PionixPublic/reference-hardware/(threads)

Thread 5 (2023-12-28):

DNF in schematics - what to do with these components

msozen, 2023-12-28:
Hi,

Maybe a stupid question, but what do we need to do with the components marked as DNF in the schematics?
There are quite a lot, and i expect that we might not be able to get the boards working without these components

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

Here is an example of one of the DNF marked components
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

Br,

corneliusclaussen, 2024-12-04:
DNF means do not fit, so they are not populated on the boards

Thread 9 (2024-12-03):

Control Pilot Signal to PLC jumpers

brandonprry, 2024-12-03:
If powering the Yak board via the 12v power supply separate from the Yeti, how should I connect a control pilot signal to the PLC jumpers on the board for ISO15118 communication?

Please let me know if this question doesn't make sense.

corneliusclaussen, 2024-12-04:
Not sure how your setup looks like. Are you using a yeti or not? In case you only use the yak you will need to have a CP generator externally that creates the pwm (and implements the evse_board_support in Everest), that yak only has the PLC modem and it is connected to the CP signal on the 10 pin connector.

brandonprry, 2024-12-04:
Thanks for the response.

I'm currently experimenting with an ISO15118-20-enabled EVSE and simulating an electric vehicle with the Fluke FEV100. The FEV100 exposes the Control Pilot and I'm attempting to use the Yak separate from the Yeti to perform the EV-side of the V2G communication.

I'm not 100% sure this will work, but I don't see a reason it shouldn't work. I'll test with the J10 pin as soon as possible.

brandonprry, 2024-12-04:
Or should I power the Yak via the 12v port then jumper the pin for the Control Pilot in the 10-pin connector?

brandonprry, 2024-12-04:
Perfect, thanks so much.

corneliusclaussen, 2024-12-04:
The CP is connected from Fluke to CP on the 10pin connector on yak. There is only one 10pin connector that normally connects to yeti. Yak will add the PLC signal to the CP wire.
