PionixPublic/reference-hardware/Yak/CM4_GPIO.kicad_sch

## KiCad design Yak/CM4_GPIO.kicad_sch (2022-12-22)

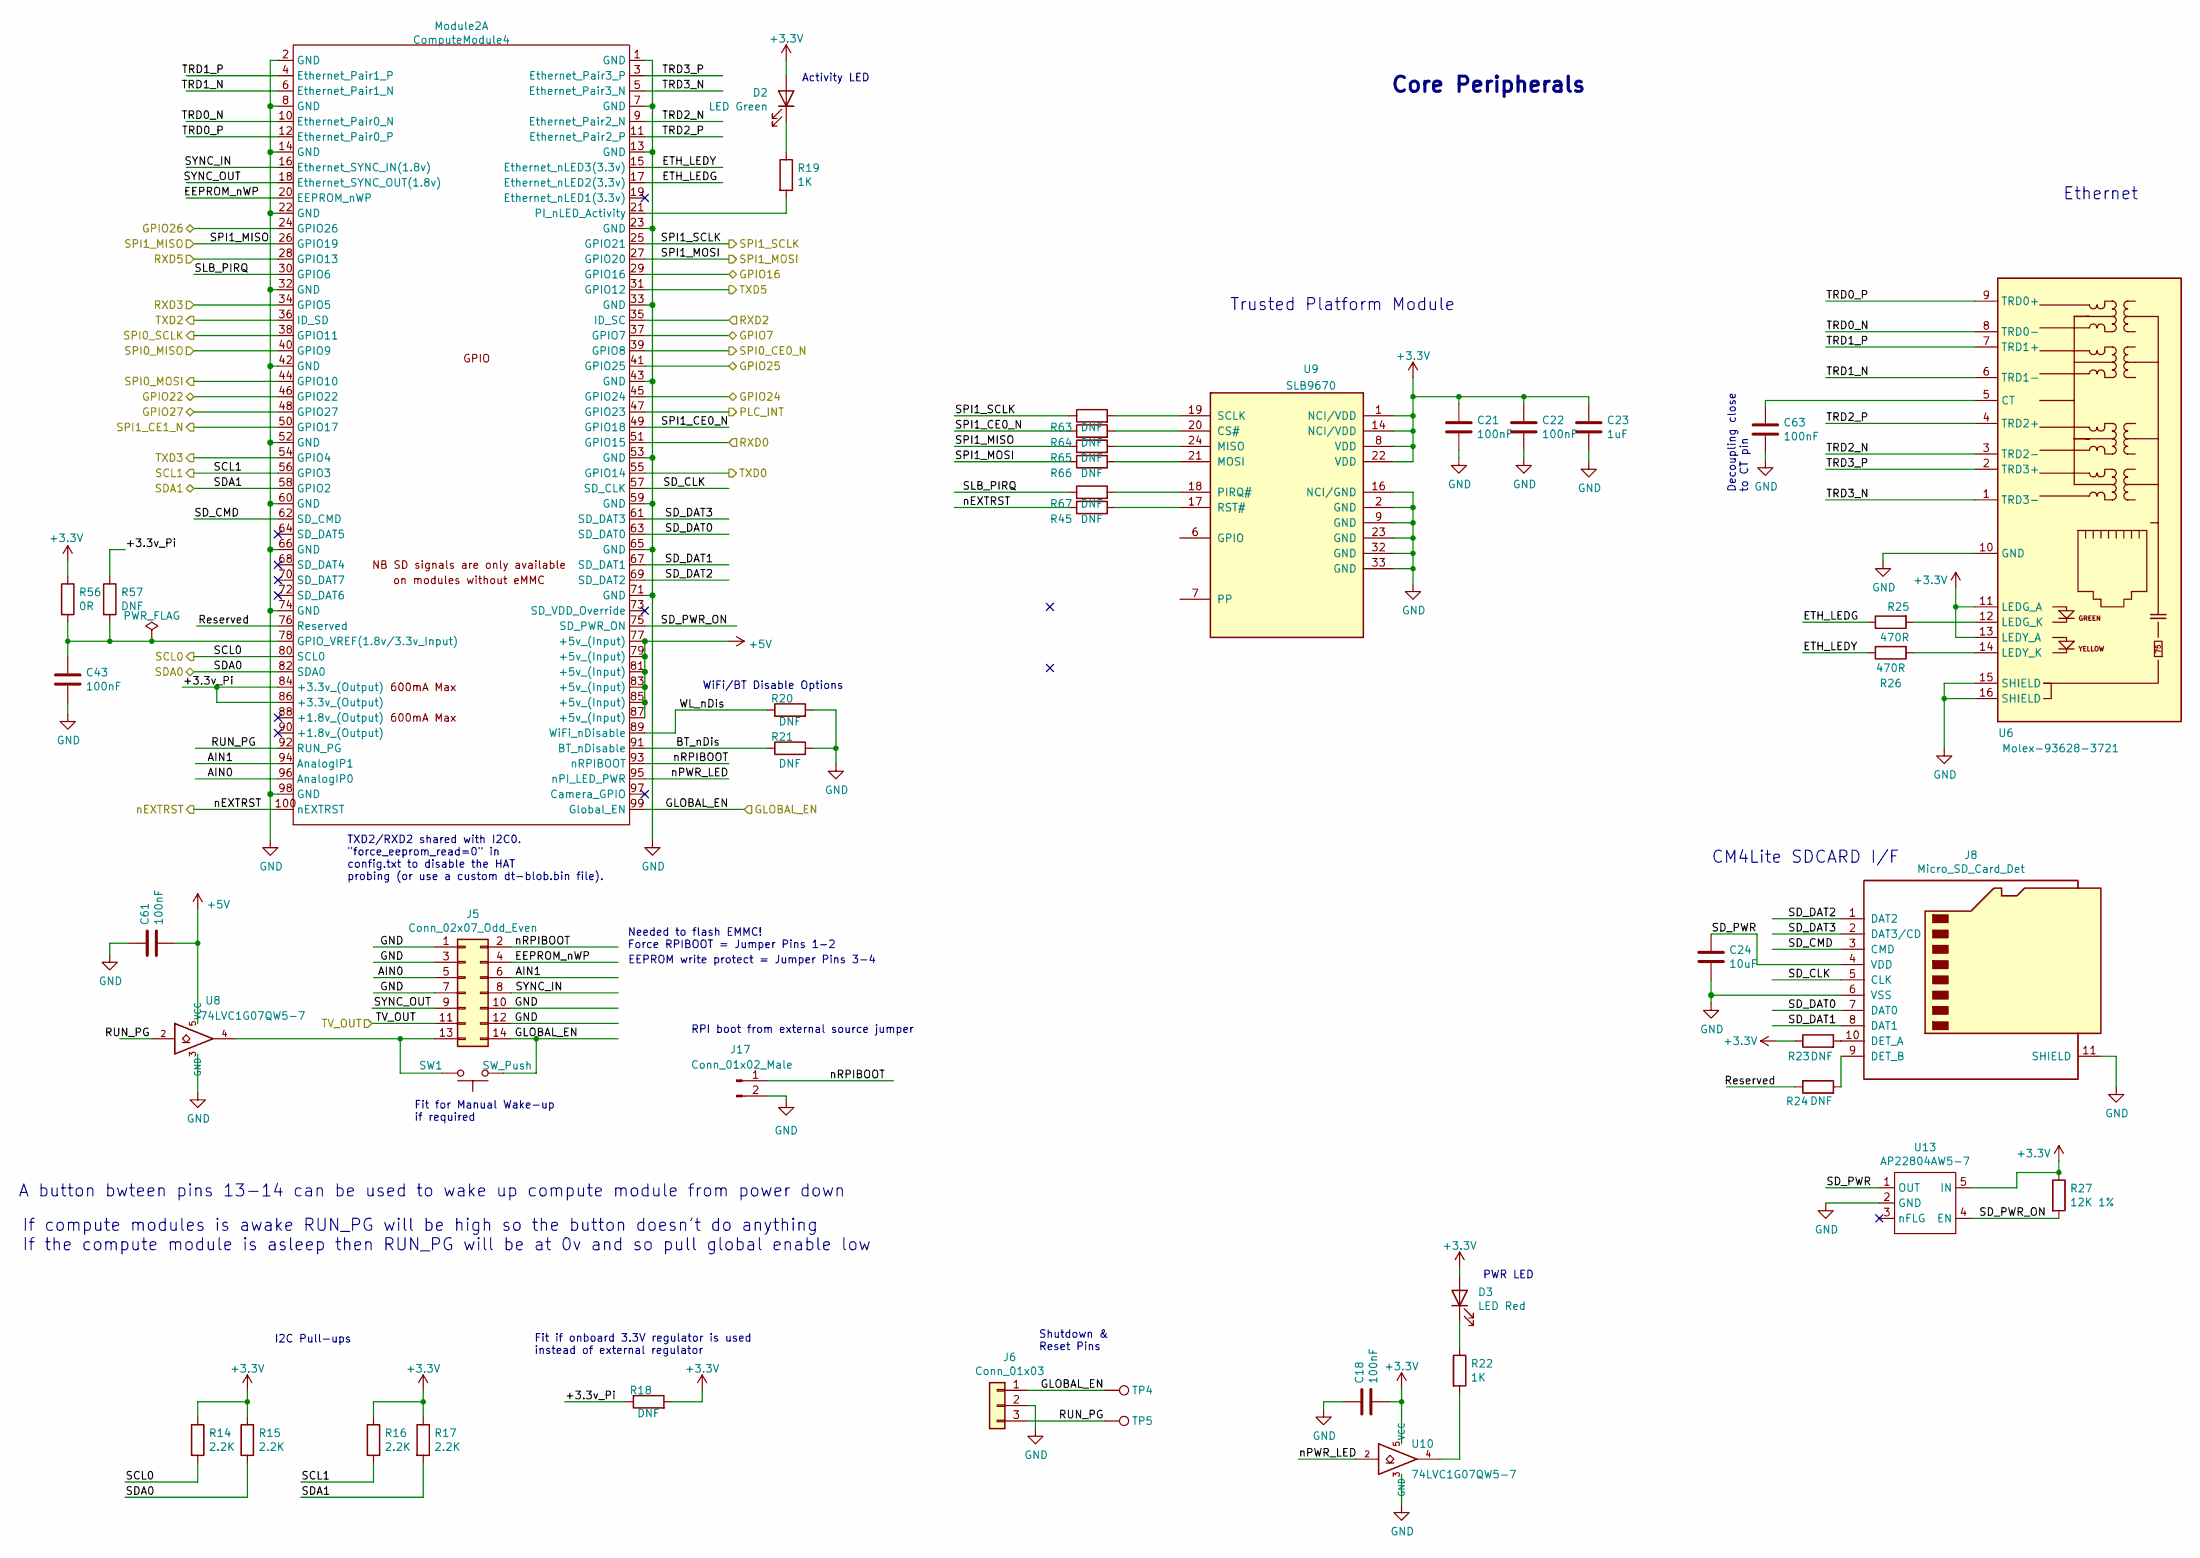
[picture p5: schematic CM4_GPIO.kicad_sch]

Parts:
C18, C21, C22, C43, C61, C63: 100nF; C_0603_1608Metric
C23: 1uF; C_0603_1608Metric
C24: 10uF; C_0805_2012Metric
D2: LED Green; LED_0603_1608Metric; Part Description Green 572nm LED Indication - Discrete 2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
D3: LED Red; LED_0603_1608Metric; Part Description Red 620nm LED Indication - Discrete 2.2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
J5: Conn_02x07_Odd_Even; PinHeader_2x07_P1.27mm_Vertical; Part Description Pin Header, Vertical, Board-to-Board, 1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
J6: Conn_01x03; PinHeader_1x03_P1.27mm_Vertical; Part Description Pin Header, Board-to-Board, 1.27 mm, 1 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
J8: Micro_SD_Card_Det; SDCARD_MOLEX_503398-1892; Part Description 9 (8 + 1) Position Card Connector micro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
J17: Conn_01x02_Male; PinHeader_1x02_P2.54mm_Vertical
Module2: ComputeModule4; Raspberry-Pi-4-Compute-Module; Part Description 100 Position Connector Receptacle, Cent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
R14, R15, R16, R17: 2.2K; R_0603_1608Metric
R18, R20, R21, R23, R24, R45, R57, R63, R64, R65, R66, R67: DNF; R_0603_1608Metric
R19, R22: 1K; R_0603_1608Metric
R25, R26: 470R; R_0603_1608Metric
R27: 12K 1%; R_0603_1608Metric
R56: 0R; R_0603_1608Metric
SW1: SW_Push; SW_Push_1P1T_NO_CK_KMR2; Part Description Tactile Switch, PTSActuated, Surface Mo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
TP4, TP5: TestPoint; TestPoint_THTPad_D1.0mm_Drill0.5mm
U6: Molex-93628-3721; RJ45_Molex_93628-3721_Horizontal; Part Description Modular Connector, RJ45 Jack, 1 x 1 (Po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
U8, U10: 74LVC1G07QW5-7; SOT-23-5; Part Description Buffer, Non-Inverting 1 Element 1 Bit p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
U9: SLB9670; VQFN-32-1EP_5x5mm_P0.5mm_EP3.5x3.5mm; Part Description Trusted Platform Module (TPM)
U13: AP22804AW5-7; SOT-23-5; Part Description Power Switch/Driver 1:1 N-Channel 2.5A 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

Connections:
+3.3V: C18.2, C21.1, C22.1, C23.1, D2.2 (A), D3.2 (A), R14.1, R15.1, R16.1, R17.1, R18.2, R23.1, R27.1, R56.1, U6.11 (LEDG_A), U6.13 (LEDY_A), U9.1 (NCI/VDD), U9.8 (VDD), U9.14 (NCI/VDD), U9.22 (VDD), U10.5 (VCC), U13.5 (IN)
+3.3v_Pi: Module2.84 (+3.3v_(Output)), Module2.86 (+3.3v_(Output)), R18.1, R57.1
+5V: C61.2, Module2.77 (+5v_(Input)), Module2.79 (+5v_(Input)), Module2.81 (+5v_(Input)), Module2.83 (+5v_(Input)), Module2.85 (+5v_(Input)), Module2.87 (+5v_(Input)), U8.5 (VCC)
AIN0: J5.5, Module2.96 (AnalogIP0)
AIN1: J5.6, Module2.94 (AnalogIP1)
BT_nDis: Module2.91 (BT_nDisable), R21.1
EEPROM_nWP: J5.4, Module2.20 (EEPROM_nWP)
ETH_LEDG: Module2.17 (Ethernet_nLED2(3.3v)), R25.1
ETH_LEDY: Module2.15 (Ethernet_nLED3(3.3v)), R26.1
GLOBAL_EN: J5.14, J6.1, Module2.99 (Global_EN), SW1.1, TP4.1
GND: C18.1, C21.2, C22.2, C23.2, C24.2, C43.2, C61.1, C63.2, J5.1, J5.3, J5.7, J5.10, J5.12, J6.2, J8.6 (VSS), J8.11 (SHIELD), J17.2, Module2.1 (GND), Module2.2 (GND), Module2.7 (GND), Module2.8 (GND), Module2.13 (GND), Module2.14 (GND), Module2.22 (GND), Module2.23 (GND), Module2.32 (GND), Module2.33 (GND), Module2.42 (GND), Module2.43 (GND), Module2.52 (GND), Module2.53 (GND), Module2.59 (GND), Module2.60 (GND), Module2.65 (GND), Module2.66 (GND), Module2.71 (GND), Module2.74 (GND), Module2.98 (GND), R20.2, R21.2, U6.10 (GND), U6.15 (SHIELD), U6.16 (SHIELD), U8.3 (GND), U9.2 (GND), U9.9 (GND), U9.16 (NCI/GND), U9.23 (GND), U9.32 (GND), U9.33 (GND), U10.3 (GND), U13.2 (GND)
GPIO7: Module2.37 (GPIO7)
GPIO16: Module2.29 (GPIO16)
GPIO22: Module2.46 (GPIO22)
GPIO24: Module2.45 (GPIO24)
GPIO25: Module2.41 (GPIO25)
GPIO26: Module2.24 (GPIO26)
GPIO27: Module2.48 (GPIO27)
unnamed: C43.1, Module2.78 (GPIO_VREF(1.8v/3.3v_Input)), R56.2, R57.2
unnamed: C63.1, U6.5 (CT)
unnamed: D2.1 (K), R19.1
unnamed: D3.1 (K), R22.1
unnamed: J5.13, SW1.2, U8.4
unnamed: J8.9 (DET_B), R24.2
unnamed: J8.10 (DET_A), R23.2
unnamed: Module2.21 (PI_nLED_Activity), R19.2
unnamed: R22.2, U10.4
unnamed: R25.2, U6.12 (LEDG_K)
unnamed: R26.2, U6.14 (LEDY_K)
unnamed: R45.2, U9.17 (RST#)
unnamed: R63.2, U9.19 (SCLK)
unnamed: R64.2, U9.20 (CS#)
unnamed: R65.2, U9.24 (MISO)
unnamed: R66.2, U9.21 (MOSI)
unnamed: R67.2, U9.18 (PIRQ#)
PLC_INT: Module2.47 (GPIO23)
RUN_PG: J6.3, Module2.92 (RUN_PG), TP5.1, U8.2
RXD0: Module2.51 (GPIO15)
RXD2: Module2.35 (ID_SC)
RXD3: Module2.34 (GPIO5)
RXD5: Module2.28 (GPIO13)
Reserved: Module2.76 (Reserved), R24.1
SCL0: Module2.80 (SCL0), R14.2
SCL1: Module2.56 (GPIO3), R16.2
SDA0: Module2.82 (SDA0), R15.2
SDA1: Module2.58 (GPIO2), R17.2
SD_CLK: J8.5 (CLK), Module2.57 (SD_CLK)
SD_CMD: J8.3 (CMD), Module2.62 (SD_CMD)
SD_DAT0: J8.7 (DAT0), Module2.63 (SD_DAT0)
SD_DAT1: J8.8 (DAT1), Module2.67 (SD_DAT1)
SD_DAT2: J8.1 (DAT2), Module2.69 (SD_DAT2)
SD_DAT3: J8.2 (DAT3/CD), Module2.61 (SD_DAT3)
SD_PWR: C24.1, J8.4 (VDD), U13.1 (OUT)
SD_PWR_ON: Module2.75 (SD_PWR_ON), R27.2, U13.4 (EN)
SLB_PIRQ: Module2.30 (GPIO6), R67.1
SPI0_CE0_N: Module2.39 (GPIO8)
SPI0_MISO: Module2.40 (GPIO9)
SPI0_MOSI: Module2.44 (GPIO10)
SPI0_SCLK: Module2.38 (GPIO11)
SPI1_CE0_N: Module2.49 (GPIO18), R64.1
SPI1_CE1_N: Module2.50 (GPIO17)
SPI1_MISO: Module2.26 (GPIO19), R65.1
SPI1_MOSI: Module2.27 (GPIO20), R66.1
SPI1_SCLK: Module2.25 (GPIO21), R63.1
SYNC_IN: J5.8, Module2.16 (Ethernet_SYNC_IN(1.8v))
SYNC_OUT: J5.9, Module2.18 (Ethernet_SYNC_OUT(1.8v))
TRD0_N: Module2.10 (Ethernet_Pair0_N), U6.8 (TRD0-)
TRD0_P: Module2.12 (Ethernet_Pair0_P), U6.9 (TRD0+)
TRD1_N: Module2.6 (Ethernet_Pair1_N), U6.6 (TRD1-)
TRD1_P: Module2.4 (Ethernet_Pair1_P), U6.7 (TRD1+)
TRD2_N: Module2.9 (Ethernet_Pair2_N), U6.3 (TRD2-)
TRD2_P: Module2.11 (Ethernet_Pair2_P), U6.4 (TRD2+)
TRD3_N: Module2.5 (Ethernet_Pair3_N), U6.1 (TRD3-)
TRD3_P: Module2.3 (Ethernet_Pair3_P), U6.2 (TRD3+)
TV_OUT: J5.11
TXD0: Module2.55 (GPIO14)
TXD2: Module2.36 (ID_SD)
TXD3: Module2.54 (GPIO4)
TXD5: Module2.31 (GPIO12)
WL_nDis: Module2.89 (WiFi_nDisable), R20.1
nEXTRST: Module2.100 (nEXTRST), R45.1
nPWR_LED: Module2.95 (nPI_LED_PWR), U10.2
nRPIBOOT: J5.2, J17.1, Module2.93 (nRPIBOOT)

Notes on the sheet:
A button bwteen pins 13-14 can be used to wake up compute module from power down
Activity LED
Ethernet
Fit for Manual Wake-up if required
WiFi/BT Disable Options
I2C Pull-ups
TXD2/RXD2 shared with I2C0. "force_eeprom_read=0" in config.txt to disable the HAT probing (or use a custom dt-blob.bin file).
EEPROM write protect = Jumper Pins 3-4
If compute modules is awake RUN_PG will be high so the button doesn't do anything If the compute module is asleep then RUN_PG will be at 0v and so pull global enable low
Fit if onboard 3.3V regulator is used instead of external regulator
Decoupling close to CT pin
RPI boot from external source jumper
CM4Lite SDCARD I/F
Needed to flash EMMC! Force RPIBOOT = Jumper Pins 1-2
Core Peripherals
Shutdown & Reset Pins
Trusted Platform Module
PWR LED
