PionixPublic/reference-hardware/Yak/CM4_HighSpeed.kicad_sch

## KiCad design Yak/CM4_HighSpeed.kicad_sch (2022-12-22)

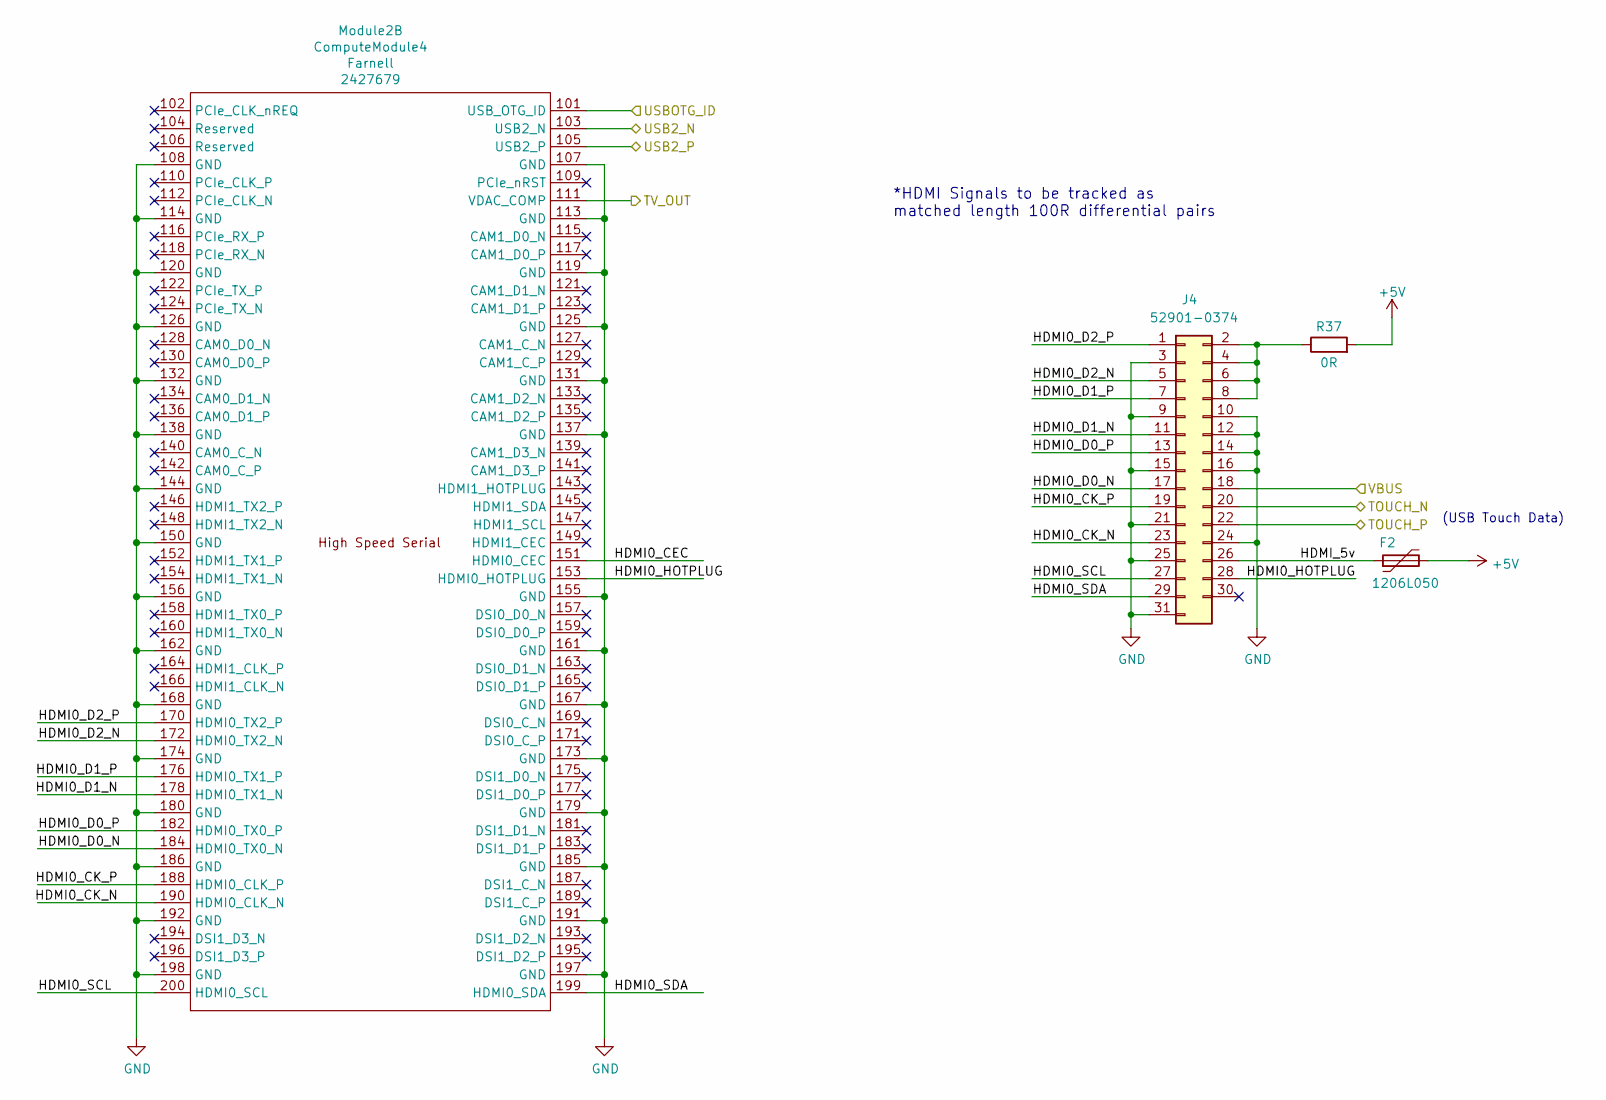
[picture p6: schematic CM4_HighSpeed.kicad_sch]

Parts:
F2: 1206L050; Fuse_1206_3216Metric; Part Description Polymeric PTC ReseFuse 6V 500 mA Ih Sur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
J4: 52901-0374; Molex_SlimStack_52901-0374_2x15_P0.635mm_Vertical; Part Description 30 Position Connector Receptacle, Cente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
Module2: ComputeModule4; Raspberry-Pi-4-Compute-Module; Part Description 100 Position Connector Receptacle, Cent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
R37: 0R; R_0603_1608Metric

Connections:
+5V: F2.2, R37.2
GND: J4.3, J4.9, J4.10, J4.12, J4.14, J4.15, J4.16, J4.21, J4.24, J4.25, J4.31, Module2.107 (GND), Module2.108 (GND), Module2.113 (GND), Module2.114 (GND), Module2.119 (GND), Module2.120 (GND), Module2.125 (GND), Module2.126 (GND), Module2.131 (GND), Module2.132 (GND), Module2.137 (GND), Module2.138 (GND), Module2.144 (GND), Module2.150 (GND), Module2.155 (GND), Module2.156 (GND), Module2.161 (GND), Module2.162 (GND), Module2.167 (GND), Module2.168 (GND), Module2.173 (GND), Module2.174 (GND), Module2.179 (GND), Module2.180 (GND), Module2.185 (GND), Module2.186 (GND), Module2.191 (GND), Module2.192 (GND), Module2.197 (GND), Module2.198 (GND)
HDMI0_CEC: Module2.151 (HDMI0_CEC)
HDMI0_CK_N: J4.23, Module2.190 (HDMI0_CLK_N)
HDMI0_CK_P: J4.19, Module2.188 (HDMI0_CLK_P)
HDMI0_D0_N: J4.17, Module2.184 (HDMI0_TX0_N)
HDMI0_D0_P: J4.13, Module2.182 (HDMI0_TX0_P)
HDMI0_D1_N: J4.11, Module2.178 (HDMI0_TX1_N)
HDMI0_D1_P: J4.7, Module2.176 (HDMI0_TX1_P)
HDMI0_D2_N: J4.5, Module2.172 (HDMI0_TX2_N)
HDMI0_D2_P: J4.1, Module2.170 (HDMI0_TX2_P)
HDMI0_HOTPLUG: J4.28, Module2.153 (HDMI0_HOTPLUG)
HDMI0_SCL: J4.27, Module2.200 (HDMI0_SCL)
HDMI0_SDA: J4.29, Module2.199 (HDMI0_SDA)
HDMI_5v: F2.1, J4.26
unnamed: J4.2, J4.4, J4.6, J4.8, R37.1
TOUCH_N: J4.20
TOUCH_P: J4.22
TV_OUT: Module2.111 (VDAC_COMP)
USB2_N: Module2.103 (USB2_N)
USB2_P: Module2.105 (USB2_P)
USBOTG_ID: Module2.101 (USB_OTG_ID)
VBUS: J4.18

Notes on the sheet:
*HDMI Signals to be tracked as matched length 100R differential pairs
(USB Touch Data)
