PionixPublic/reference-hardware/Yak/RTC.kicad_sch

## KiCad design Yak/RTC.kicad_sch (2022-12-22)

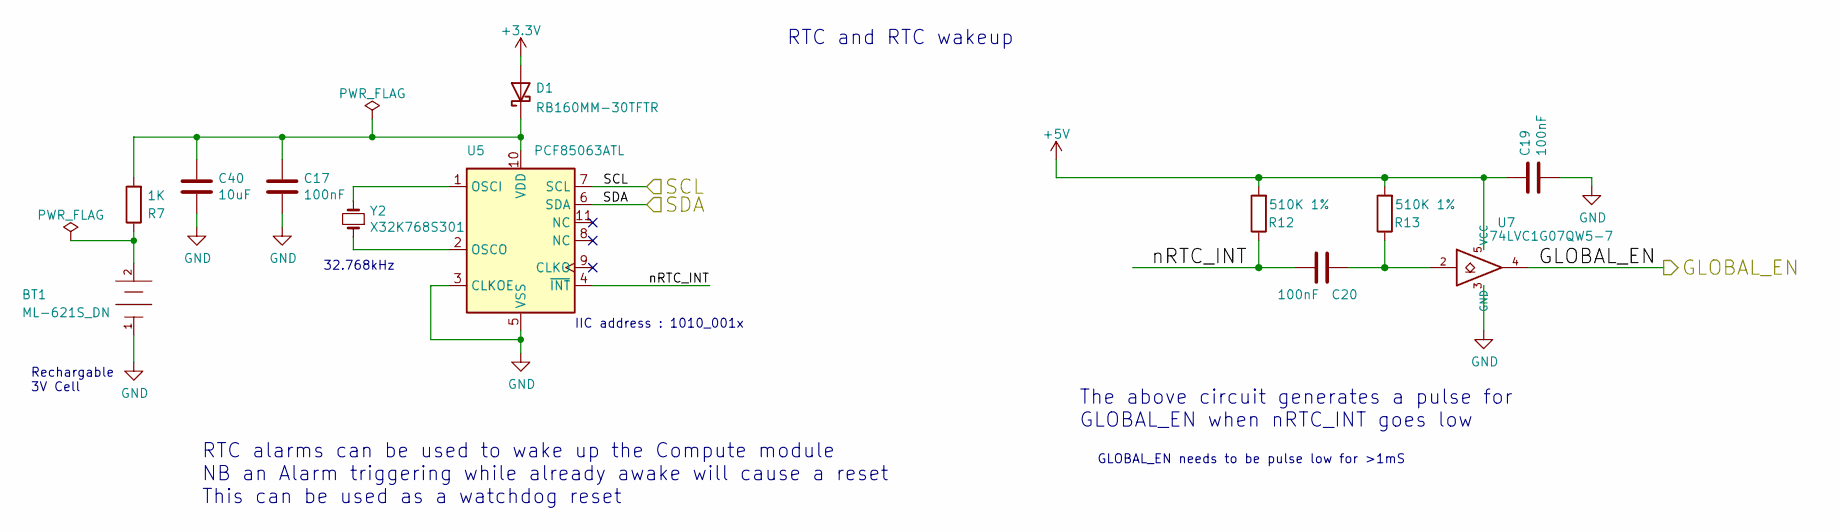
[picture p7: schematic RTC.kicad_sch]

Parts:
BT1: ML-621S_DN; Panasonic-ML-621S_DN-0-0-MFG; mouser part number 658-ML-621S/DN; digikey description BATTERY LITH 3V 5MAH COIN 6.8MM
C17, C19, C20: 100nF; C_0603_1608Metric
C40: 10uF; C_0805_2012Metric
D1: RB160MM-30TFTR; D_SOD-123F; Part Description 30V 1A SOD-123F 480mV Schottky Diode
R7: 1K; R_0603_1608Metric
R12, R13: 510K 1%; R_0603_1608Metric
U5: PCF85063ATL; NXP_Semiconductors-SOT1197-1-02_2016-0-MFG; Part Description Realtime Clock/Calendar I2C Interface
U7: 74LVC1G07QW5-7; SOT-23-5; Part Description Buffer, Non-Inverting 1 Element 1 Bit p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
Y2: X32K768S301; Crystal_SMD_3215-2Pin_3.2x1.5mm; Part Description Crystal 32.768KHz 7pF 20pmm

Connections:
+3.3V: D1.2 (A)
+5V: C19.1, R12.2, R13.2, U7.5 (VCC)
GLOBAL_EN: U7.4
GND: BT1.1 (CATHODE), C17.2, C19.2, C40.2, U5.3 (CLKOE), U5.5 (VSS), U7.3 (GND)
unnamed: BT1.2 (ANODE), R7.1
unnamed: C17.1, C40.1, D1.1 (K), R7.2, U5.10 (VDD)
unnamed: C20.1, R13.1, U7.2
unnamed: U5.1 (OSCI), Y2.2
unnamed: U5.2 (OSCO), Y2.1
SCL: U5.7 (SCL)
SDA: U5.6 (SDA)
nRTC_INT: C20.2, R12.1, U5.4 (~INT)

Notes on the sheet:
RTC and RTC wakeup
The above circuit generates a pulse for GLOBAL_EN when nRTC_INT goes low
Rechargable 3V Cell
32.768kHz
GLOBAL_EN needs to be pulse low for >1mS
RTC alarms can be used to wake up the Compute module NB an Alarm triggering while already awake will cause a reset This can be used as a watchdog reset
IIC address : 1010_001x
