PionixPublic/reference-hardware/Yak/USB2-HUB.kicad_sch

## KiCad design Yak/USB2-HUB.kicad_sch (2022-12-22)

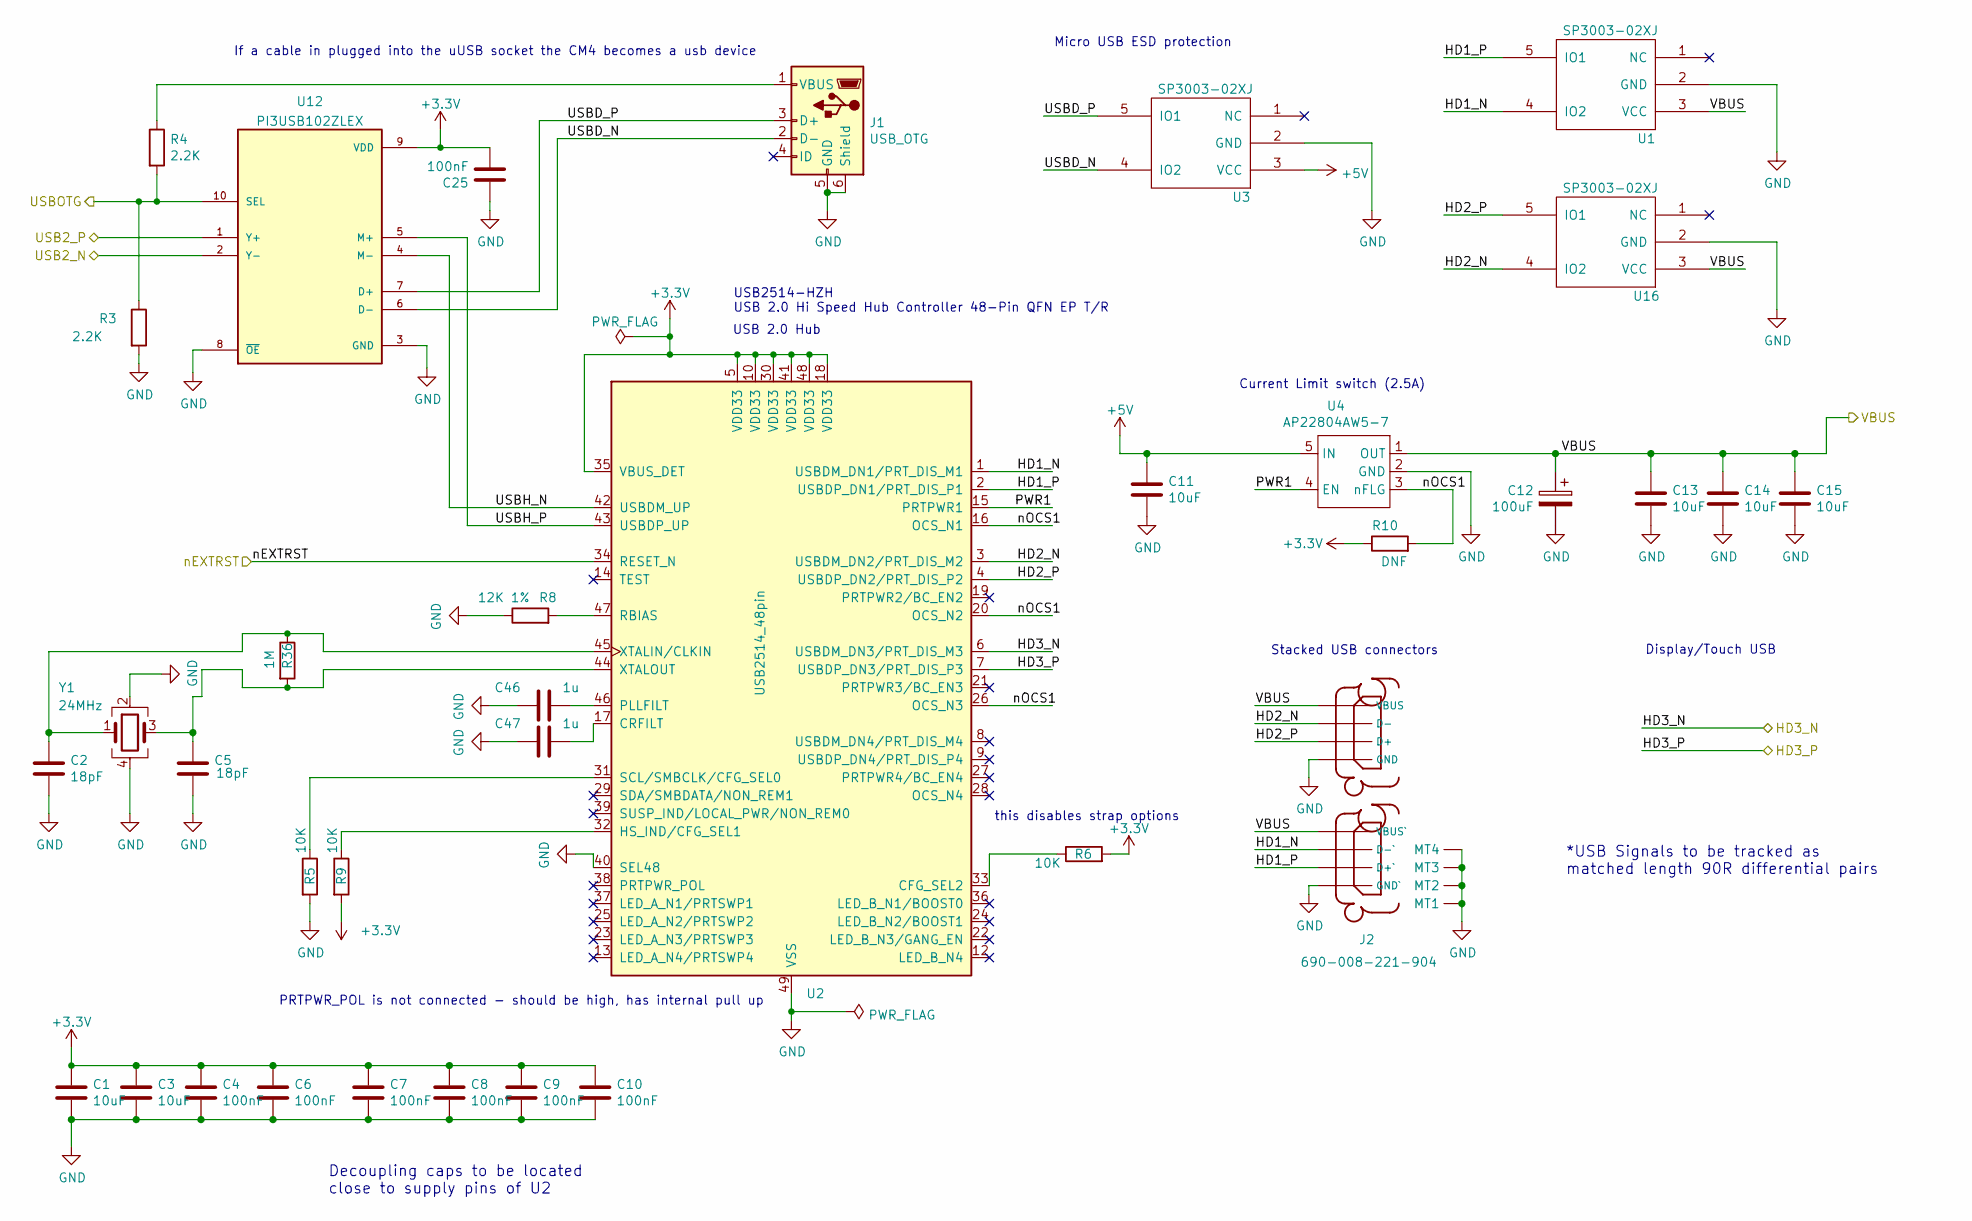
[picture p8: schematic USB2-HUB.kicad_sch]

Parts:
C1, C3, C11, C13, C14, C15: 10uF; C_0805_2012Metric
C2, C5: 18pF; C_0603_1608Metric
C4, C6, C7, C8, C9, C10, C25: 100nF; C_0603_1608Metric
C12: 100uF; CP_Elec_6.3x3; Part Description 100 µF 16 V Aluminum - Polymer Capacito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
C46, C47: 1u; C_0603_1608Metric
J1: USB_OTG; USB_Micro-B_EDAC_UCON00686; Part Description USB - micro B USB 2.0 Receptacle Connec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
J2: 690-008-221-904; MOLEX_USB_67298-4090; Part Description USB-A (USB TYPE-A), Stacked Receptacle 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
R3, R4: 2.2K; R_0603_1608Metric
R5, R6, R9: 10K; R_0603_1608Metric
R8: 12K 1%; R_0603_1608Metric
R10: DNF; R_0603_1608Metric
R36: 1M; R_0603_1608Metric
U1, U3, U16: SP3003-02XJ; SC70-5; Part Description TVS Diode USB
U2: USB2514_48pin; QFN-48-1EP_7x7mm_P0.5mm_EP4.1x4.1mm
U4: AP22804AW5-7; SOT-23-5; Part Description Power Switch/Driver 1:1 N-Channel 2.5A 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
U12: PI3USB102ZLEX; SW_PI3USB102ZLEX; Part Description USB Switch IC 1 Channel 10-TQFN
Y1: 24MHz; Crystal_SMD_Abracon_ABM8G-4Pin_3.2x2.5mm; Part Description Crystal, 24 MHz, SMD, 3.2mm x 2.5mm, 10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

Connections:
+3.3V: C1.1, C3.1, C4.1, C6.1, C7.1, C8.1, C9.1, C10.1, C25.2, R6.2, R9.2, R10.1, U2.5 (VDD33), U2.10 (VDD33), U2.18 (VDD33), U2.30 (VDD33), U2.35 (VBUS_DET), U2.41 (VDD33), U2.48 (VDD33), U12.9 (VDD)
+5V: C11.1, U3.3 (VCC), U4.5 (IN)
GND: C1.2, C2.2, C3.2, C4.2, C5.2, C6.2, C7.2, C8.2, C9.2, C10.2, C11.2, C12.2, C13.2, C14.2, C15.2, C25.1, C46.1, C47.1, J1.5 (GND), J1.6 (Shield), J2.4 (GND`), J2.8 (GND), J2.MT1, J2.MT2, J2.MT3, J2.MT4, R3.2, R5.2, R8.1, U1.2 (GND), U2.40 (SEL48), U2.49 (VSS), U3.2 (GND), U4.2 (GND), U12.3 (GND), U12.8 (~OE), U16.2 (GND), Y1.2, Y1.4
HD1_N: J2.2 (D-`), U1.4 (IO2), U2.1 (USBDM_DN1/PRT_DIS_M1)
HD1_P: J2.3 (D+`), U1.5 (IO1), U2.2 (USBDP_DN1/PRT_DIS_P1)
HD2_N: J2.6 (D-), U2.3 (USBDM_DN2/PRT_DIS_M2), U16.4 (IO2)
HD2_P: J2.7 (D+), U2.4 (USBDP_DN2/PRT_DIS_P2), U16.5 (IO1)
HD3_N: U2.6 (USBDM_DN3/PRT_DIS_M3)
HD3_P: U2.7 (USBDP_DN3/PRT_DIS_P3)
unnamed: C2.1, R36.1, U2.45 (XTALIN/CLKIN), Y1.1
unnamed: C5.1, R36.2, U2.44 (XTALOUT), Y1.3
unnamed: C46.2, U2.46 (PLLFILT)
unnamed: C47.2, U2.17 (CRFILT)
unnamed: J1.1 (VBUS), R4.1
unnamed: R5.1, U2.31 (SCL/SMBCLK/CFG_SEL0)
unnamed: R6.1, U2.33 (CFG_SEL2)
unnamed: R8.2, U2.47 (RBIAS)
unnamed: R9.1, U2.32 (HS_IND/CFG_SEL1)
PWR1: U2.15 (PRTPWR1), U4.4 (EN)
USB2_N: U12.2 (Y-)
USB2_P: U12.1 (Y+)
USBD_N: J1.2 (D-), U3.4 (IO2), U12.6 (D-)
USBD_P: J1.3 (D+), U3.5 (IO1), U12.7 (D+)
USBH_N: U2.42 (USBDM_UP), U12.4 (M-)
USBH_P: U2.43 (USBDP_UP), U12.5 (M+)
USBOTG: R3.1, R4.2, U12.10 (SEL)
VBUS: C12.1, C13.1, C14.1, C15.1, J2.1 (VBUS`), J2.5 (VBUS), U1.3 (VCC), U4.1 (OUT), U16.3 (VCC)
nEXTRST: U2.34 (RESET_N)
nOCS1: R10.2, U2.16 (OCS_N1), U2.20 (OCS_N2), U2.26 (OCS_N3), U4.3 (nFLG)

Notes on the sheet:
USB 2.0 Hub
*USB Signals to be tracked as matched length 90R differential pairs
Display/Touch USB
Current Limit switch (2.5A)
USB2514-HZH USB 2.0 Hi Speed Hub Controller 48-Pin QFN EP T/R
PRTPWR_POL is not connected - should be high, has internal pull up
Stacked USB connectors
If a cable in plugged into the uUSB socket the CM4 becomes a usb device
Decoupling caps to be located close to supply pins of U2
this disables strap options
Micro USB ESD protection
