PionixPublic/reference-hardware/Yak/everestCM4.kicad_sch

## KiCad design Yak/everestCM4.kicad_sch (2022-12-22)

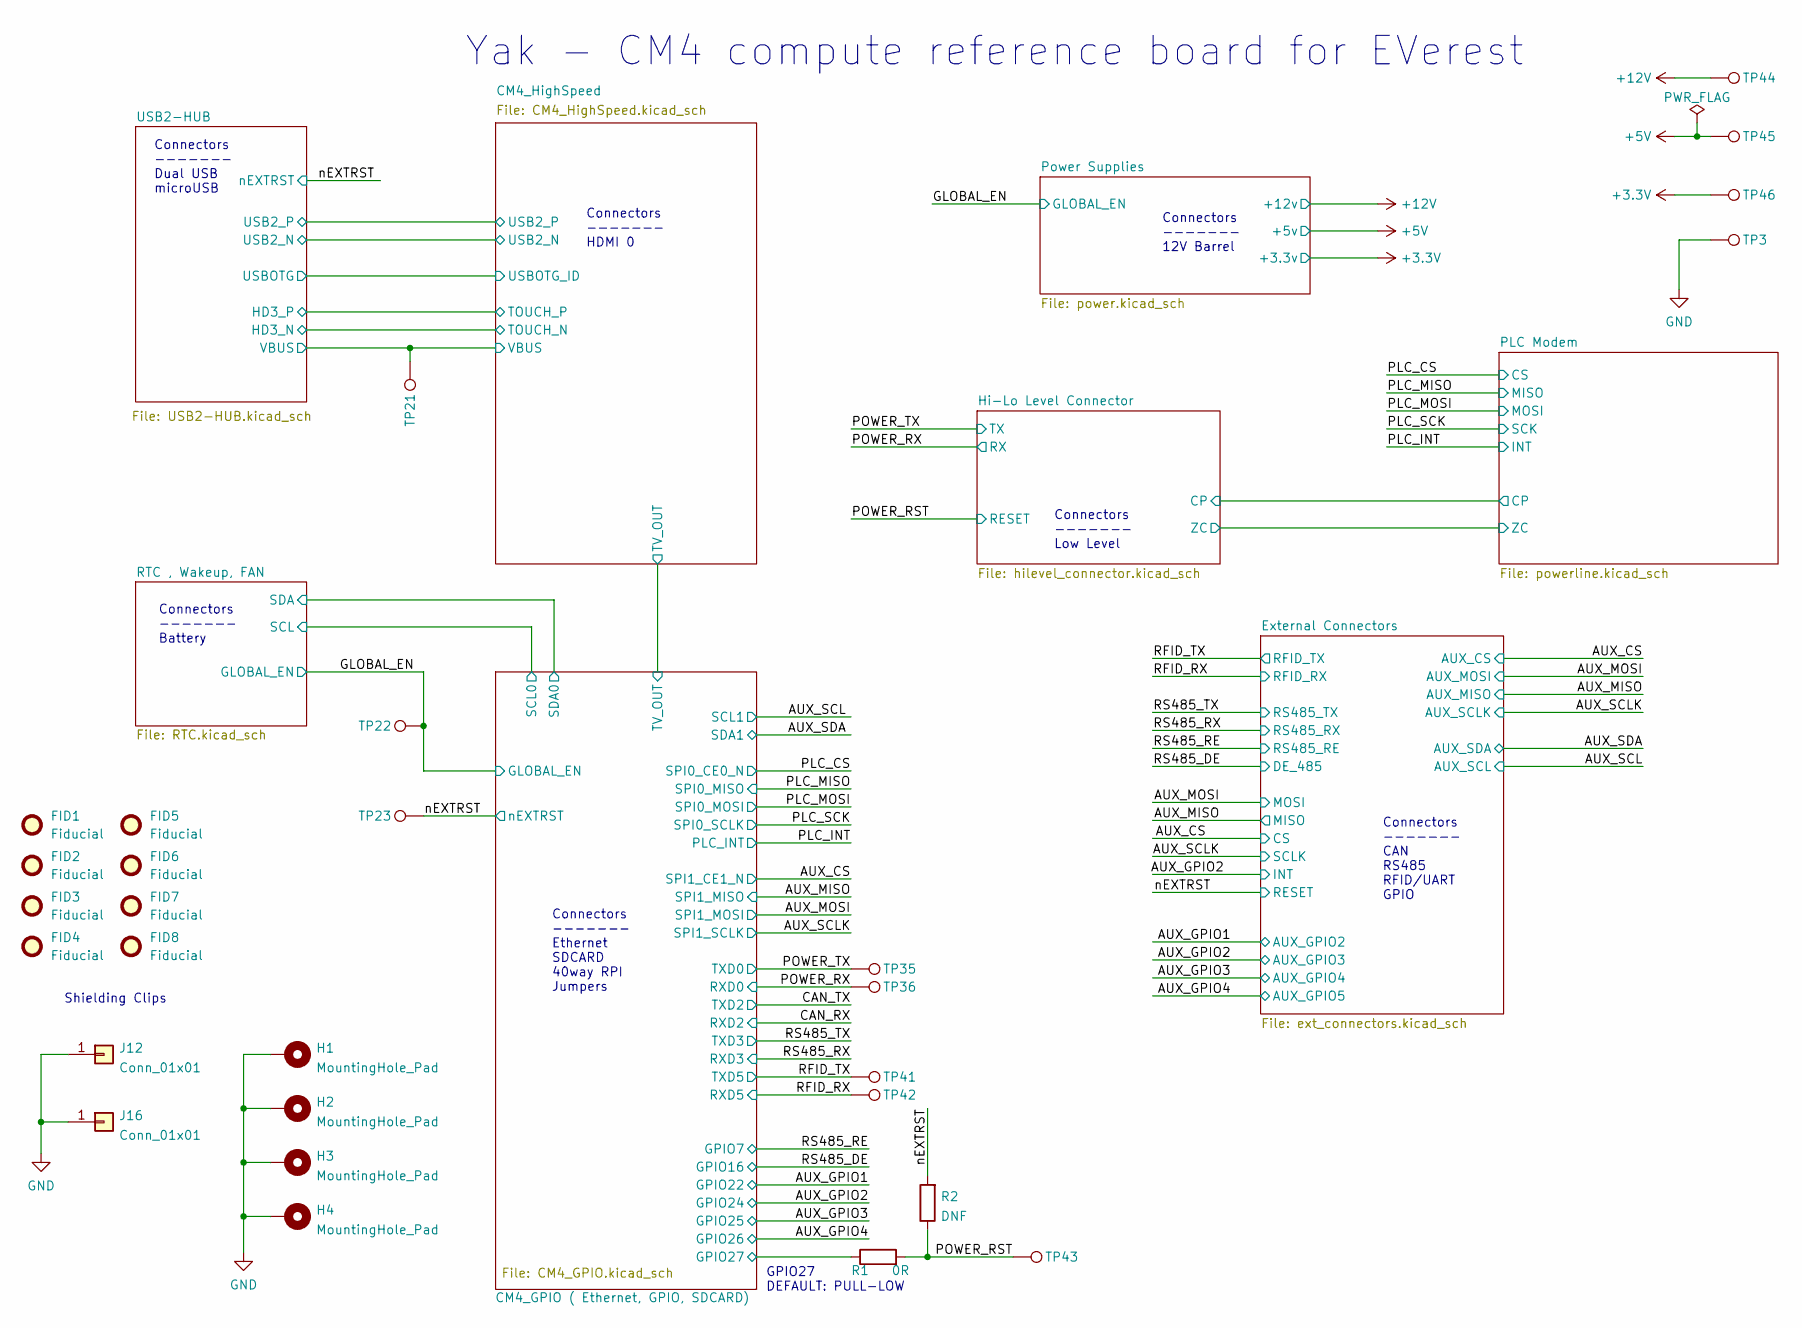
[picture p9: schematic everestCM4.kicad_sch]

Parts:
FID1, FID2, FID3, FID4, FID5, FID6, FID7, FID8: Fiducial; Fiducial_1mm_Mask3mm
H1, H2, H3, H4: MountingHole_Pad; MountingHole_3.2mm_M3_ISO7380_Pad
J12, J16: Conn_01x01; S2711-46R_SheildClip; Part Description Sheilding Clip
R1: 0R; R_0603_1608Metric
R2: DNF; R_0603_1608Metric
TP3, TP21, TP22, TP23, TP35, TP36, TP41, TP42, TP43, TP44, TP45, TP46: TestPoint; TestPoint_THTPad_D1.0mm_Drill0.5mm

Connections:
+3.3V: TP46.1
+5V: TP45.1
+12V: TP44.1
GLOBAL_EN: TP22.1
GND: H1.1, H2.1, H3.1, H4.1, J12.1, J16.1, TP3.1
GPIO27: R1.1
POWER_RST: R1.2, R2.1, TP43.1
POWER_RX: TP36.1
POWER_TX: TP35.1
RFID_RX: TP42.1
RFID_TX: TP41.1
VBUS: TP21.1
nEXTRST: R2.2, TP23.1

Notes on the sheet:
Connectors ------- Ethernet SDCARD 40way RPI Jumpers
Connectors ------- HDMI 0
GPIO27 DEFAULT: PULL-LOW
Connectors ------- Dual USB microUSB
Connectors ------- CAN RS485 RFID/UART GPIO
Connectors ------- Low Level
Yak - CM4 compute reference board for EVerest
Connectors ------- Battery
Connectors ------- 12V Barrel
Shielding Clips
