PionixPublic/reference-hardware/Yak/ext_connectors.kicad_sch

## KiCad design Yak/ext_connectors.kicad_sch (2022-12-22)

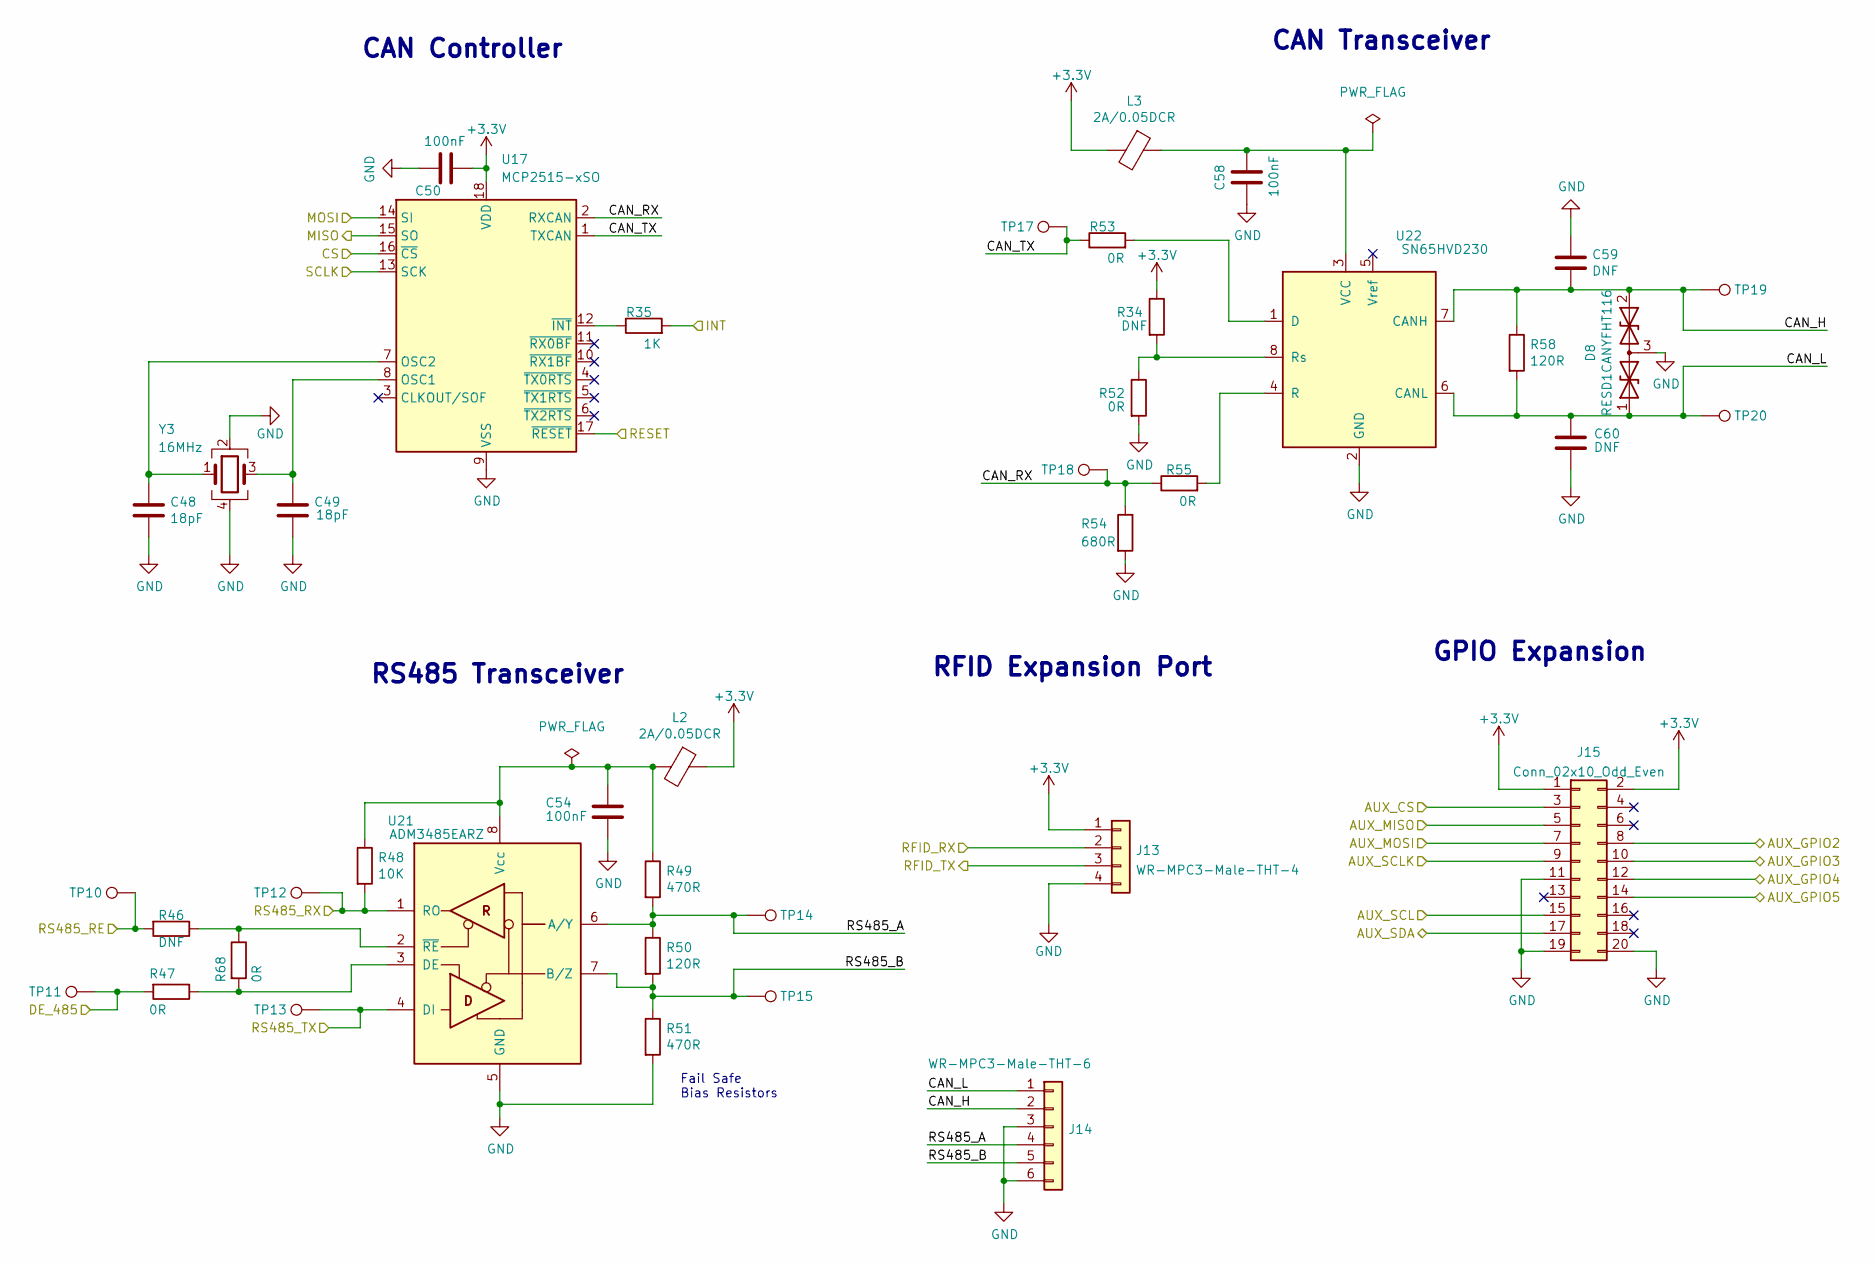
[picture p10: schematic ext_connectors.kicad_sch]

Parts:
C48, C49: 18pF; C_0603_1608Metric
C50, C54, C58: 100nF; C_0603_1608Metric
C59, C60: DNF; C_0603_1608Metric
D8: RESD1CANYFHT116; SOT-23; Part Description TVS Diode for CAN Bus
J13: WR-MPC3-Male-THT-4; 66200421022; Part Description Pin Header, Plastic Peg, Wire-to-Board,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
J14: WR-MPC3-Male-THT-6; 66200621022; Part Description Pin Header, Plastic Peg, Wire-to-Board,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
J15: Conn_02x10_Odd_Even; WE62702021621_PinSocket_2x10_P1.27mm_Vertical; Part Description Pin Header, Board-to-Board, 1.27 mm, 2 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
L2: 2A/0.05DCR; L_0402_1005Metric; Part Description Ferrite Bead, 0402 [1005 Metric], 120 o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
L3: 2A/0.05DCR; L_0603_1608Metric; Part Description Ferrite Bead, 0402 [1005 Metric], 120 o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
R34, R46: DNF; R_0603_1608Metric
R35: 1K; R_0603_1608Metric
R47, R52, R53, R55, R68: 0R; R_0603_1608Metric
R48: 10K; R_0603_1608Metric
R49, R51: 470R; R_0603_1608Metric
R50, R58: 120R; R_0603_1608Metric
R54: 680R; R_0603_1608Metric
TP10, TP11, TP12, TP13, TP14, TP15, TP17, TP18, TP19, TP20: TestPoint; TestPoint_THTPad_D1.0mm_Drill0.5mm
U17: MCP2515-xSO; SOIC-18W_7.5x11.6mm_P1.27mm
U21: ADM3485EARZ; SOIC-8_3.9x4.9mm_P1.27mm; Part Description Half Duplex, 10Mbps RS485/RS422
U22: SN65HVD230; SOIC-8_3.9x4.9mm_P1.27mm; Part Description CAN Transceiver
Y3: 16MHz; Crystal_SMD_Abracon_ABM8G-4Pin_3.2x2.5mm; Part Description Crystal, 24 MHz, SMD, 3.2mm x 2.5mm, 10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

Connections:
+3.3V: C50.1, J13.1, J15.1, J15.2, L2.1, L3.2, R34.1, U17.18 (VDD)
AUX_CS: J15.3
AUX_GPIO2: J15.8
AUX_GPIO3: J15.10
AUX_GPIO4: J15.12
AUX_GPIO5: J15.14
AUX_MISO: J15.5
AUX_MOSI: J15.7
AUX_SCL: J15.15
AUX_SCLK: J15.9
AUX_SDA: J15.17
CAN_H: C59.2, D8.2 (A2), J14.2, R58.1, TP19.1, U22.7 (CANH)
CAN_L: C60.2, D8.1 (A1), J14.1, R58.2, TP20.1, U22.6 (CANL)
CAN_RX: R54.1, R55.1, TP18.1, U17.2 (RXCAN)
CAN_TX: R53.1, TP17.1, U17.1 (TXCAN)
CS: U17.16 (~CS)
DE_485: R47.2, TP11.1
GND: C48.2, C49.2, C50.2, C54.2, C58.1, C59.1, C60.1, D8.3 (common), J13.4, J14.3, J14.6, J15.11, J15.19, J15.20, R51.2, R52.2, R54.2, U17.9 (VSS), U21.5 (GND), U22.2 (GND), Y3.2, Y3.4
INT: R35.2
MISO: U17.15 (SO)
MOSI: U17.14 (SI)
unnamed: C48.1, U17.7 (OSC2), Y3.1
unnamed: C49.1, U17.8 (OSC1), Y3.3
unnamed: C54.1, L2.2, R48.1, R49.1, U21.8 (Vcc)
unnamed: C58.2, L3.1, U22.3 (VCC)
unnamed: R34.2, R52.1, U22.8 (Rs)
unnamed: R35.1, U17.12 (~INT)
unnamed: R46.1, R68.1, U21.2 (~RE)
unnamed: R47.1, R68.2, U21.3 (DE)
unnamed: R53.2, U22.1 (D)
unnamed: R55.2, U22.4 (R)
RESET: U17.17 (~RESET)
RFID_RX: J13.2
RFID_TX: J13.3
RS485_A: J14.4, R49.2, R50.1, TP14.1, U21.6 (A/Y)
RS485_B: J14.5, R50.2, R51.1, TP15.1, U21.7 (B/Z)
RS485_RE: R46.2, TP10.1
RS485_RX: R48.2, TP12.1, U21.1 (RO)
RS485_TX: TP13.1, U21.4 (DI)
SCLK: U17.13 (SCK)

Notes on the sheet:
CAN Controller
CAN Transceiver
RS485 Transceiver
GPIO Expansion
RFID Expansion Port
Fail Safe Bias Resistors
