PionixPublic/reference-hardware/Yak/hilevel_connector.kicad_sch

## KiCad design Yak/hilevel_connector.kicad_sch (2022-12-22)

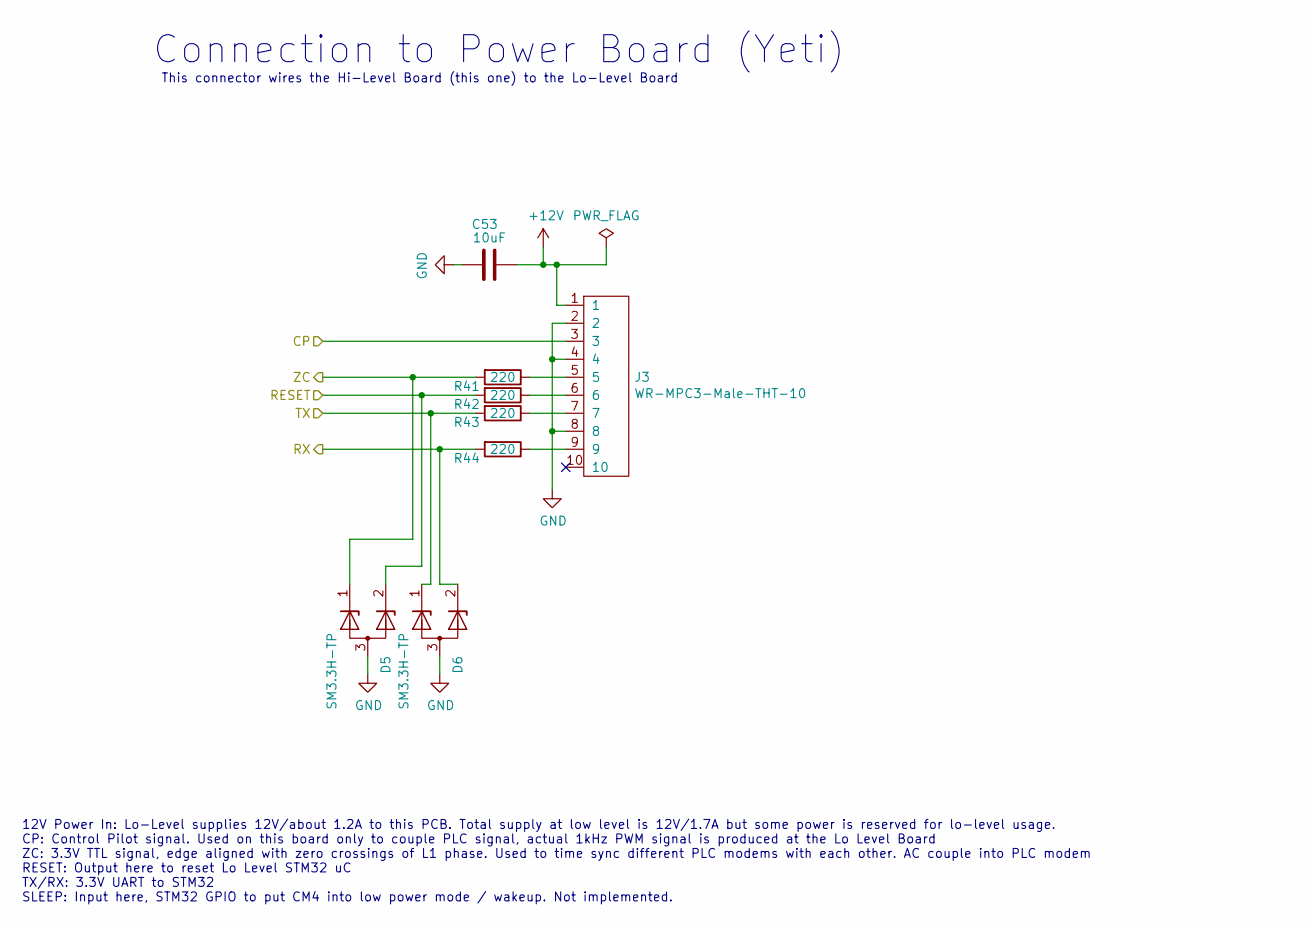
[picture p11: schematic hilevel_connector.kicad_sch]

Parts:
C53: 10uF; C_0805_2012Metric
D5, D6: SM3.3H-TP; SOT-23; Part Description 2.5V Clamp 40A (8/20µs) Ipp Tvs Diode S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
J3: WR-MPC3-Male-THT-10; 66201021022; Part Description Connector Header Through Hole, Right An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
R41, R42, R43, R44: 220; R_0603_1608Metric

Connections:
+12V: C53.1, J3.1
CP: J3.3
GND: C53.2, D5.3 (A), D6.3 (A), J3.2, J3.4, J3.8
unnamed: J3.5, R41.1
unnamed: J3.6, R42.1
unnamed: J3.7, R43.1
unnamed: J3.9, R44.1
RESET: D5.2 (K), R42.2
RX: D6.2 (K), R44.2
TX: D6.1 (K), R43.2
ZC: D5.1 (K), R41.2

Notes on the sheet:
12V Power In: Lo-Level supplies 12V/about 1.2A to this PCB. Total supply at low level is 12V/1.7A but some power is reserved for lo-level usage. CP: Control Pilot signal. Used on this board only to couple PLC signal, actual 1kHz PWM signal is produced at the Lo Level Board ZC: 3.3V TTL signal, edge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
Connection to Power Board (Yeti)
This connector wires the Hi-Level Board (this one) to the Lo-Level Board
