PionixPublic/reference-hardware/Yak/power.kicad_sch

## KiCad design Yak/power.kicad_sch (2022-12-22)

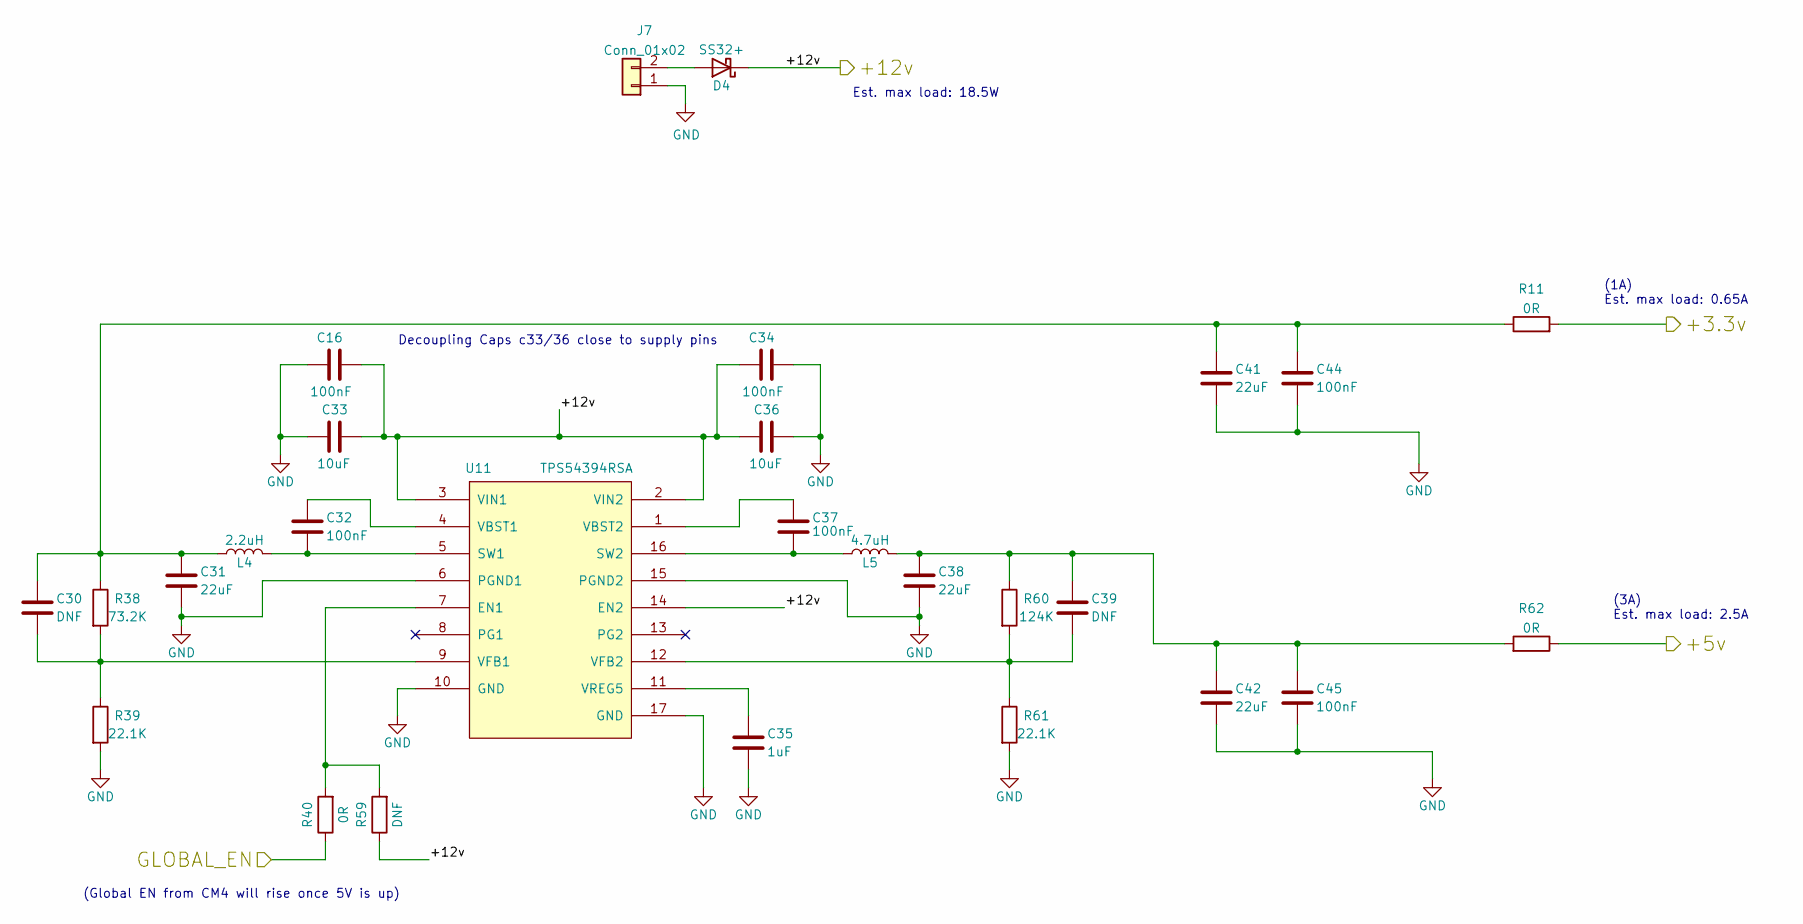
[picture p12: schematic power.kicad_sch]

Parts:
C16, C32, C34, C37, C44, C45: 100nF; C_0603_1608Metric
C30, C39: DNF; C_0603_1608Metric
C31, C38, C41, C42: 22uF; C_1206_3216Metric; Part Description SMD Multilayer Ceramic Capacitor, 22 µF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
C33, C36: 10uF; C_0805_2012Metric
C35: 1uF; C_0603_1608Metric
D4: SS32+; D_SMC; Part Description Schottky Rectifier, 20 V, 3 A, Single, 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
J7: Conn_01x02; PinHeader_1x02_P2.54mm_Vertical
L4: 2.2uH; L_Vishay_IHLP-1616; Part Description Power Inductor (SMD), 2.2 µH, 3.25 A, S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
L5: 4.7uH; L_Vishay_IHLP-2525; Part Description Power Inductor (SMD), 4.7 µH, 4 A, Shie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
R11, R40, R62: 0R; R_0603_1608Metric
R38: 73.2K; R_0603_1608Metric
R39, R61: 22.1K; R_0603_1608Metric
R59: DNF; R_0603_1608Metric
R60: 124K; R_0603_1608Metric
U11: TPS54394RSA; QFN-16-1EP_4x4mm_P0.65mm_EP2.7x2.7mm_ThermalVias; Part Description Buck Switching Regulator IC Positive Ad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

Connections:
+3.3v: R11.2
+5v: R62.1
+12v: C16.2, C33.1, C34.1, C36.2, D4.1 (K), R59.1, U11.2 (VIN2), U11.3 (VIN1), U11.14 (EN2)
GLOBAL_EN: R40.1
GND: C16.1, C31.2, C33.2, C34.2, C35.2, C36.1, C38.2, C41.2, C42.2, C44.2, C45.2, J7.1, R39.2, R61.2, U11.6 (PGND1), U11.10 (GND), U11.15 (PGND2), U11.17 (GND)
unnamed: C30.1, C31.1, C41.1, C44.1, L4.1, R11.1, R38.1
unnamed: C30.2, R38.2, R39.1, U11.9 (VFB1)
unnamed: C32.1, U11.4 (VBST1)
unnamed: C32.2, L4.2, U11.5 (SW1)
unnamed: C35.1, U11.11 (VREG5)
unnamed: C37.1, U11.1 (VBST2)
unnamed: C37.2, L5.1, U11.16 (SW2)
unnamed: C38.1, C39.1, C42.1, C45.1, L5.2, R60.1, R62.2
unnamed: C39.2, R60.2, R61.1, U11.12 (VFB2)
unnamed: D4.2 (A), J7.2
unnamed: R40.2, R59.2, U11.7 (EN1)

Notes on the sheet:
Decoupling Caps c33/36 close to supply pins
Est. max load: 18.5W
(3A) Est. max load: 2.5A
(Global EN from CM4 will rise once 5V is up)
(1A) Est. max load: 0.65A
