PionixPublic/reference-hardware/Yak/powerline.kicad_sch

## KiCad design Yak/powerline.kicad_sch (2022-12-22)

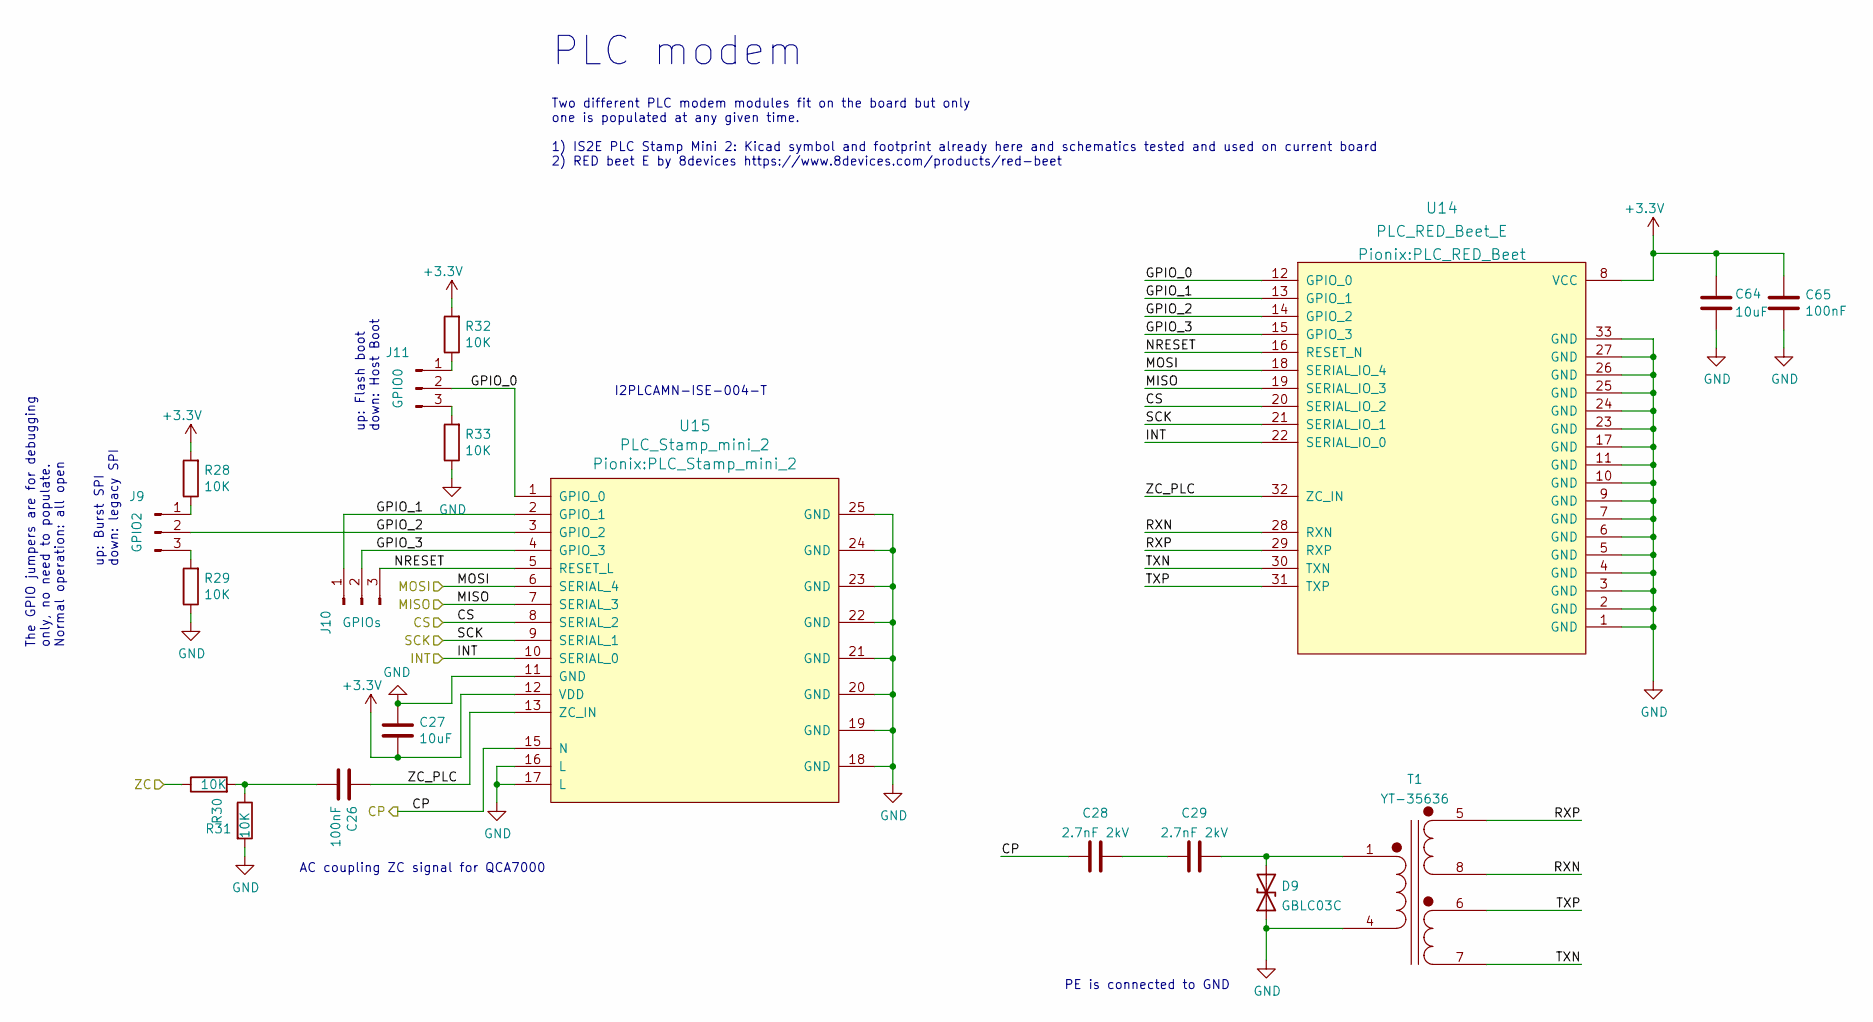
[picture p13: schematic powerline.kicad_sch]

Parts:
C26, C65: 100nF; C_0603_1608Metric
C27, C64: 10uF; C_0805_2012Metric
C28, C29: 2.7nF 2kV; C_1210_3225Metric; Part Description SMD Multilayer Ceramic Capacitor, 2700 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
D9: GBLC03C; D_SOD-323; Part Description Clamp 1A (8/20µs) Ipp Tvs Diode Surface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
J9: GPIO2; PinHeader_1x03_P1.27mm_Vertical; Part Description Pin Header, Board-to-Board, 1.27 mm, 1 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
J10: GPIOs; PinHeader_1x03_P1.27mm_Vertical; Part Description Pin Header, Board-to-Board, 1.27 mm, 1 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
J11: GPIO0; PinHeader_1x03_P1.27mm_Vertical; Part Description Pin Header, Board-to-Board, 1.27 mm, 1 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
R28, R29, R30, R31, R32, R33: 10K; R_0603_1608Metric
T1: YT-35636
U14: PLC_RED_Beet_E; PLC_RED_Beet; Part Description PLC Module Option 2
U15: PLC_Stamp_mini_2; Part Description PLC Module Option 1

Connections:
+3.3V: C27.2, C64.1, C65.1, R28.2, R32.2, U14.8 (VCC), U15.12 (VDD)
CP: C28.1, U15.15 (N)
CS: U14.20 (SERIAL_IO_2), U15.8 (SERIAL_2)
GND: C27.1, C64.2, C65.2, D9.1 (A1), R29.1, R31.2, R33.1, T1.4 (AB), U14.1 (GND), U14.2 (GND), U14.3 (GND), U14.4 (GND), U14.5 (GND), U14.6 (GND), U14.7 (GND), U14.9 (GND), U14.10 (GND), U14.11 (GND), U14.17 (GND), U14.23 (GND), U14.24 (GND), U14.25 (GND), U14.26 (GND), U14.27 (GND), U14.33 (GND), U15.11 (GND), U15.16 (L), U15.17 (L), U15.18 (GND), U15.19 (GND), U15.20 (GND), U15.21 (GND), U15.22 (GND), U15.23 (GND), U15.24 (GND), U15.25 (GND)
GPIO_0: J11.2, U14.12 (GPIO_0), U15.1 (GPIO_0)
GPIO_1: J10.1, U14.13 (GPIO_1), U15.2 (GPIO_1)
GPIO_2: J9.2, U14.14 (GPIO_2), U15.3 (GPIO_2)
GPIO_3: J10.2, U14.15 (GPIO_3), U15.4 (GPIO_3)
INT: U14.22 (SERIAL_IO_0), U15.10 (SERIAL_0)
MISO: U14.19 (SERIAL_IO_3), U15.7 (SERIAL_3)
MOSI: U14.18 (SERIAL_IO_4), U15.6 (SERIAL_4)
NRESET: J10.3, U14.16 (RESET_N), U15.5 (RESET_L)
unnamed: C26.2, R30.2, R31.1
unnamed: C28.2, C29.1
unnamed: C29.2, D9.2 (A2), T1.1 (AA)
unnamed: J9.1, R28.1
unnamed: J9.3, R29.2
unnamed: J11.1, R32.1
unnamed: J11.3, R33.2
RXN: T1.8 (SB), U14.28 (RXN)
RXP: T1.5 (SA), U14.29 (RXP)
SCK: U14.21 (SERIAL_IO_1), U15.9 (SERIAL_1)
TXN: T1.7 (SD), U14.30 (TXN)
TXP: T1.6 (SC), U14.31 (TXP)
ZC: R30.1
ZC_PLC: C26.1, U14.32 (ZC_IN), U15.13 (ZC_IN)

Notes on the sheet:
The GPIO jumpers are for debugging only, no need to populate. Normal operation: all open
PE is connected to GND
up: Flash boot down: Host Boot
PLC modem
up: Burst SPI down: legacy SPI
I2PLCAMN-ISE-004-T
AC coupling ZC signal for QCA7000
Two different PLC modem modules fit on the board but only one is populated at any given time. 1) IS2E PLC Stamp Mini 2: Kicad symbol and footprint already here and schematics tested and used on current board 2) RED beet E by 8devices https://www.8devices.com/products/red-beet
