PionixPublic/reference-hardware/Yeti/CAM-M8Q.kicad_sch

## KiCad design Yeti/CAM-M8Q.kicad_sch (2022-12-22)

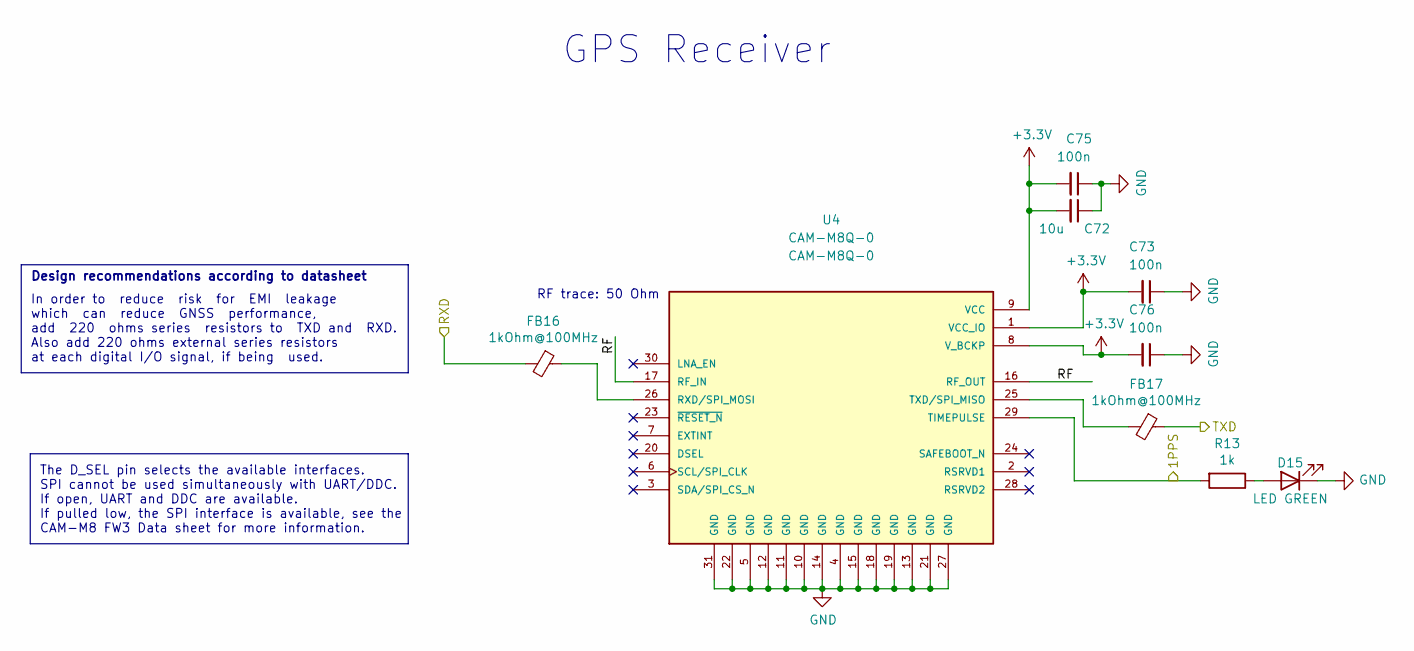
[picture p14: schematic CAM-M8Q.kicad_sch]

Parts:
C72: 10u; C_0603_1608Metric
C73, C75, C76: 100n; C_0603_1608Metric
D15: LED GREEN; LED_0603_1608Metric
FB16, FB17: 1kOhm@100MHz; L_0603_1608Metric; MPN 74279266; Digikey 732-4484-1-ND
R13: 1k; R_0603_1608Metric
U4: CAM-M8Q-0; LCC100P960X1400X210-31N; MPN CAM-M8Q-0

Connections:
1PPS: R13.2, U4.29 (TIMEPULSE)
+3.3V: C72.2, C73.2, C75.2, C76.2, U4.1 (VCC_IO), U4.8 (V_BCKP), U4.9 (VCC)
GND: C72.1, C73.1, C75.1, C76.1, D15.1 (K), U4.4 (GND), U4.5 (GND), U4.10 (GND), U4.11 (GND), U4.12 (GND), U4.13 (GND), U4.14 (GND), U4.15 (GND), U4.18 (GND), U4.19 (GND), U4.21 (GND), U4.22 (GND), U4.27 (GND), U4.31 (GND)
unnamed: D15.2 (A), R13.1
unnamed: FB16.1, U4.26 (RXD/SPI_MOSI)
unnamed: FB17.2, U4.25 (TXD/SPI_MISO)
RF: U4.16 (RF_OUT), U4.17 (RF_IN)
RXD: FB16.2
TXD: FB17.1

Notes on the sheet:
RF trace: 50 Ohm
Design recommendations according to datasheet
In order to reduce risk for EMI leakage which can reduce GNSS performance, add 220 ohms series resistors to TXD and RXD. Also add 220 ohms external series resistors at each digital I/O signal, if being used.
GPS Receiver
The D_SEL pin selects the available interfaces. SPI cannot be used simultaneously with UART/DDC. If open, UART and DDC are available. If pulled low, the SPI interface is available, see the CAM-M8 FW3 Data sheet for more information.
