PionixPublic/reference-hardware/Yeti/controller.kicad_sch

## KiCad design Yeti/controller.kicad_sch (2022-12-22)

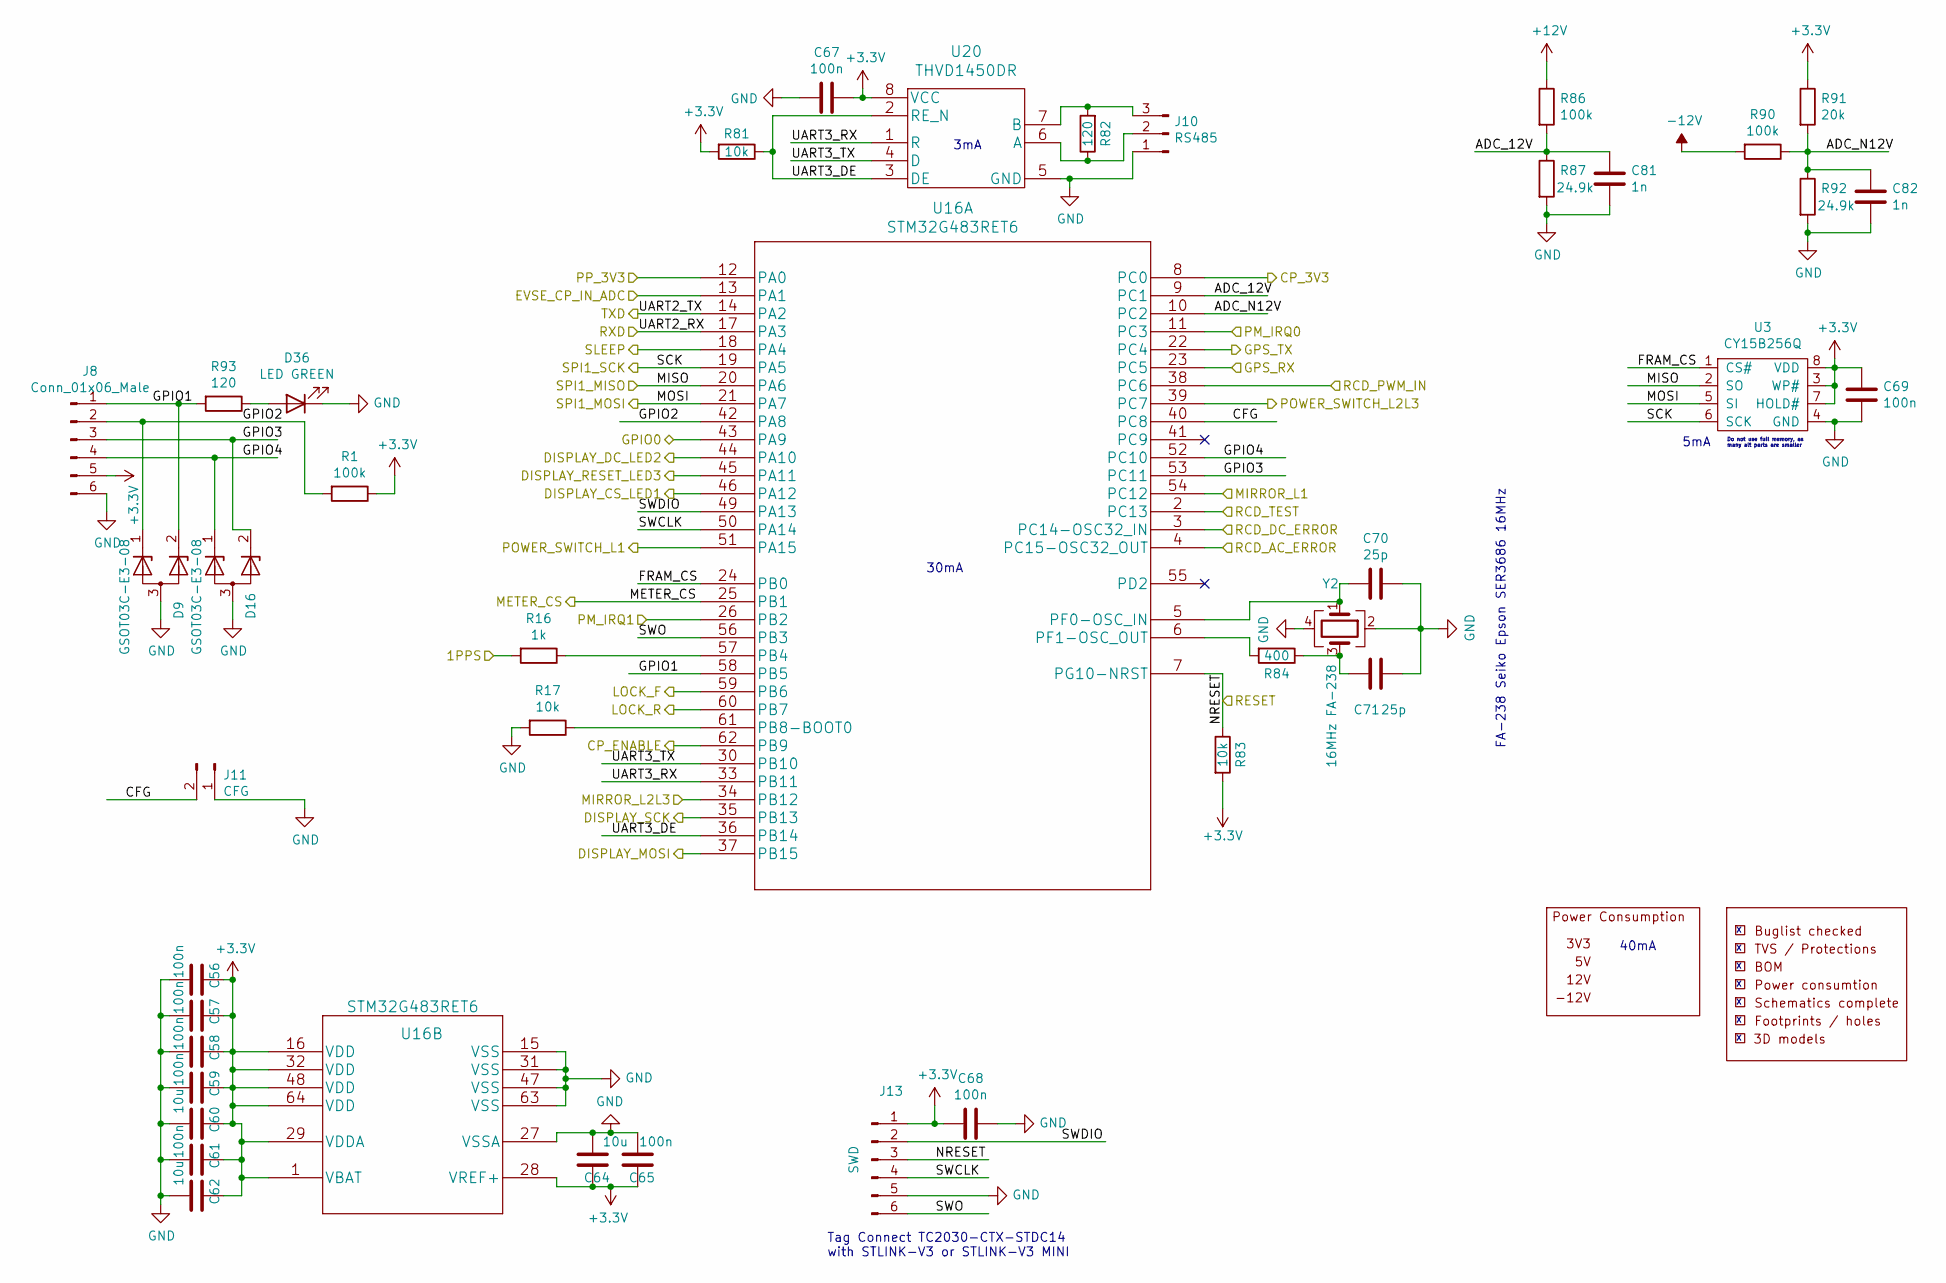
[picture p15: schematic controller.kicad_sch]

Parts:
C56, C57, C58, C59, C61, C65, C67, C68, C69: 100n; C_0603_1608Metric
C60, C62, C64: 10u; C_0603_1608Metric
C70, C71: 25p; C_0603_1608Metric
C81, C82: 1n; C_0603_1608Metric
D9, D16: GSOT03C-E3-08; SOT-23; Digikey GSOT03C-E3-08CT-ND
D36: LED GREEN; LED_0603_1608Metric
J8: Conn_01x06_Male; 66200611122
J10: RS485; 66200311122
J11: CFG; PinHeader_1x02_P2.54mm_Vertical
J13: SWD; Tag-Connect_TC2030-IDC-FP_2x03_P1.27mm_Vertical
R1, R86, R90: 100k; R_0603_1608Metric
R16: 1k; R_0603_1608Metric
R17, R81, R83: 10k; R_0603_1608Metric
R82, R93: 120; R_0603_1608Metric
R84: 400; R_0603_1608Metric
R87, R92: 24.9k; R_0603_1608Metric
R91: 20k; R_0603_1608Metric
U3: CY15B256Q; SOIC-8_3.9x4.9mm_P1.27mm; Digikey 2015-CY15B256Q-SXATCT-ND
U16: STM32G483RET6; STM32G431RBT6; MPN STM32G431RBT6; Digikey 497-19471-ND
U20: THVD1450DR; MPN THVD1450DR; Digikey 296-50395-1-ND
Y2: 16MHz FA-238; Crystal_SMD_SeikoEpson_FA238-4Pin_3.2x2.5mm; MPN FA-238 16.0000MB-C3; Digikey SER3686CT-ND

Connections:
1PPS: R16.2
+3.3V: C56.1, C57.1, C58.1, C59.1, C60.1, C61.1, C62.1, C64.1, C65.1, C67.1, C68.2, C69.1, J8.5, J13.1, R1.1, R81.2, R83.2, R91.1, U3.3 (WP#), U3.7 (HOLD#), U3.8 (VDD), U16.1 (VBAT), U16.16 (VDD), U16.28 (VREF+), U16.29 (VDDA), U16.32 (VDD), U16.48 (VDD), U16.64 (VDD), U20.8 (VCC)
+12V: R86.1
-12V: R90.2
ADC_12V: C81.1, R86.2, R87.1, U16.9 (PC1)
ADC_N12V: C82.1, R90.1, R91.2, R92.1, U16.10 (PC2)
CFG: J11.2, U16.40 (PC8)
CP_3V3: U16.8 (PC0)
CP_ENABLE: U16.62 (PB9)
DISPLAY_CS_LED1: U16.46 (PA12)
DISPLAY_DC_LED2: U16.44 (PA10)
DISPLAY_MOSI: U16.37 (PB15)
DISPLAY_RESET_LED3: U16.45 (PA11)
DISPLAY_SCK: U16.35 (PB13)
EVSE_CP_IN_ADC: U16.13 (PA1)
FRAM_CS: U3.1 (CS#), U16.24 (PB0)
GND: C56.2, C57.2, C58.2, C59.2, C60.2, C61.2, C62.2, C64.2, C65.2, C67.2, C68.1, C69.2, C70.1, C71.1, C81.2, C82.2, D9.3 (A), D16.3 (A), D36.1 (K), J8.6, J10.1, J11.1, J13.5, R17.2, R87.2, R92.2, U3.4 (GND), U16.15 (VSS), U16.27 (VSSA), U16.31 (VSS), U16.47 (VSS), U16.63 (VSS), U20.5 (GND), Y2.2, Y2.4
GPIO0: U16.43 (PA9)
GPIO1: D9.2 (K), J8.1, R93.2, U16.58 (PB5)
GPIO2: D9.1 (K), J8.2, R1.2, U16.42 (PA8)
GPIO3: D16.2 (K), J8.3, U16.53 (PC11)
GPIO4: D16.1 (K), J8.4, U16.52 (PC10)
GPS_RX: U16.23 (PC5)
GPS_TX: U16.22 (PC4)
LOCK_F: U16.59 (PB6)
LOCK_R: U16.60 (PB7)
METER_CS: U16.25 (PB1)
MIRROR_L1: U16.54 (PC12)
MIRROR_L2L3: U16.34 (PB12)
MISO: U3.2 (SO), U16.20 (PA6)
MOSI: U3.5 (SI), U16.21 (PA7)
NRESET: J13.3, R83.1, U16.7 (PG10-NRST)
unnamed: C70.2, U16.5 (PF0-OSC_IN), Y2.1
unnamed: C71.2, R84.1, Y2.3
unnamed: D36.2 (A), R93.1
unnamed: J10.2, R82.1, U20.6 (A)
unnamed: J10.3, R82.2, U20.7 (B)
unnamed: R16.1, U16.57 (PB4)
unnamed: R17.1, U16.61 (PB8-BOOT0)
unnamed: R84.2, U16.6 (PF1-OSC_OUT)
PM_IRQ0: U16.11 (PC3)
PM_IRQ1: U16.26 (PB2)
POWER_SWITCH_L1: U16.51 (PA15)
POWER_SWITCH_L2L3: U16.39 (PC7)
PP_3V3: U16.12 (PA0)
RCD_AC_ERROR: U16.4 (PC15-OSC32_OUT)
RCD_DC_ERROR: U16.3 (PC14-OSC32_IN)
RCD_PWM_IN: U16.38 (PC6)
RCD_TEST: U16.2 (PC13)
RXD: U16.17 (PA3)
SCK: U3.6 (SCK), U16.19 (PA5)
SLEEP: U16.18 (PA4)
SWCLK: J13.4, U16.50 (PA14)
SWDIO: J13.2, U16.49 (PA13)
SWO: J13.6, U16.56 (PB3)
TXD: U16.14 (PA2)
UART3_DE: R81.1, U16.36 (PB14), U20.2 (RE_N), U20.3 (DE)
UART3_RX: U16.33 (PB11), U20.1 (R)
UART3_TX: U16.30 (PB10), U20.4 (D)

Notes on the sheet:
Do not use full memory, as many alt parts are smaller
3mA
30mA
FA-238 Seiko Epson SER3686 16MHz
5mA
Tag Connect TC2030-CTX-STDC14 with STLINK-V3 or STLINK-V3 MINI
40mA
