PionixPublic/reference-hardware/Yeti/display.kicad_sch

## KiCad design Yeti/display.kicad_sch (2022-12-22)

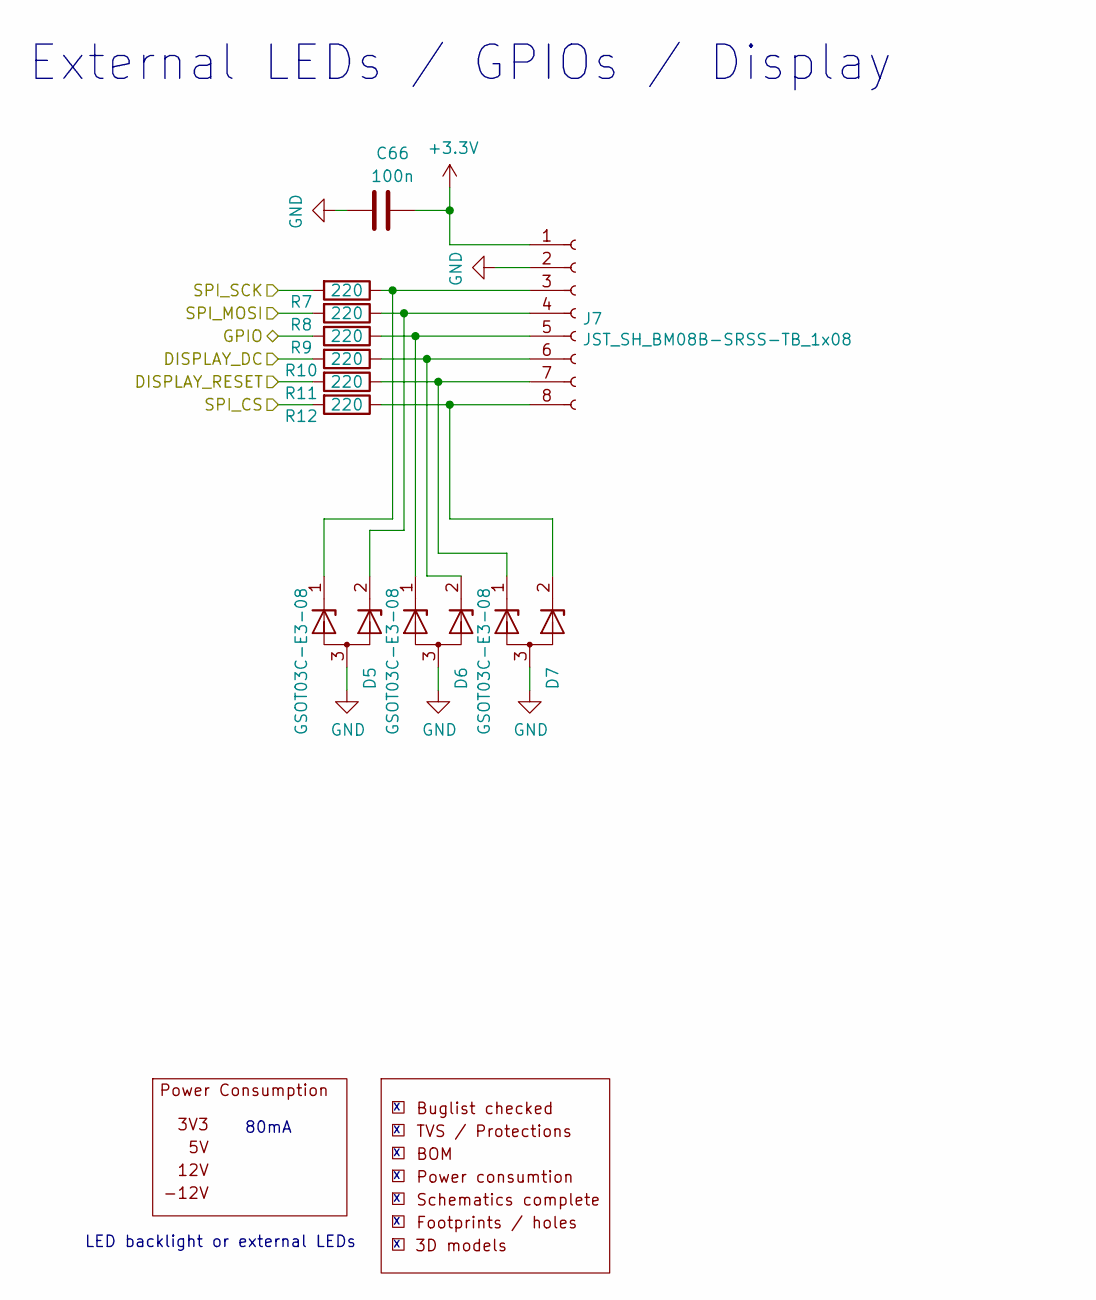
[picture p16: schematic display.kicad_sch]

Parts:
C66: 100n; C_0603_1608Metric
D5, D6, D7: GSOT03C-E3-08; SOT-23; Digikey GSOT03C-E3-08CT-ND
J7: JST_SH_BM08B-SRSS-TB_1x08; JST_SH_BM08B-SRSS-TB_1x08-1MP_P1.00mm_Vertical; Digikey 455-2959-1-ND‎
R7, R8, R9, R10, R11, R12: 220; R_0603_1608Metric

Connections:
+3.3V: C66.1, J7.1
DISPLAY_DC: R10.2
DISPLAY_RESET: R11.2
GND: C66.2, D5.3 (A), D6.3 (A), D7.3 (A), J7.2
GPIO: R9.2
unnamed: D5.1 (K), J7.3, R7.1
unnamed: D5.2 (K), J7.4, R8.1
unnamed: D6.1 (K), J7.5, R9.1
unnamed: D6.2 (K), J7.6, R10.1
unnamed: D7.1 (K), J7.7, R11.1
unnamed: D7.2 (K), J7.8, R12.1
SPI_CS: R12.2
SPI_MOSI: R8.2
SPI_SCK: R7.2

Notes on the sheet:
80mA
LED backlight or external LEDs
External LEDs / GPIOs / Display
