PionixPublic/reference-hardware/Yeti/evse.kicad_sch

## KiCad design Yeti/evse.kicad_sch (2022-12-22)

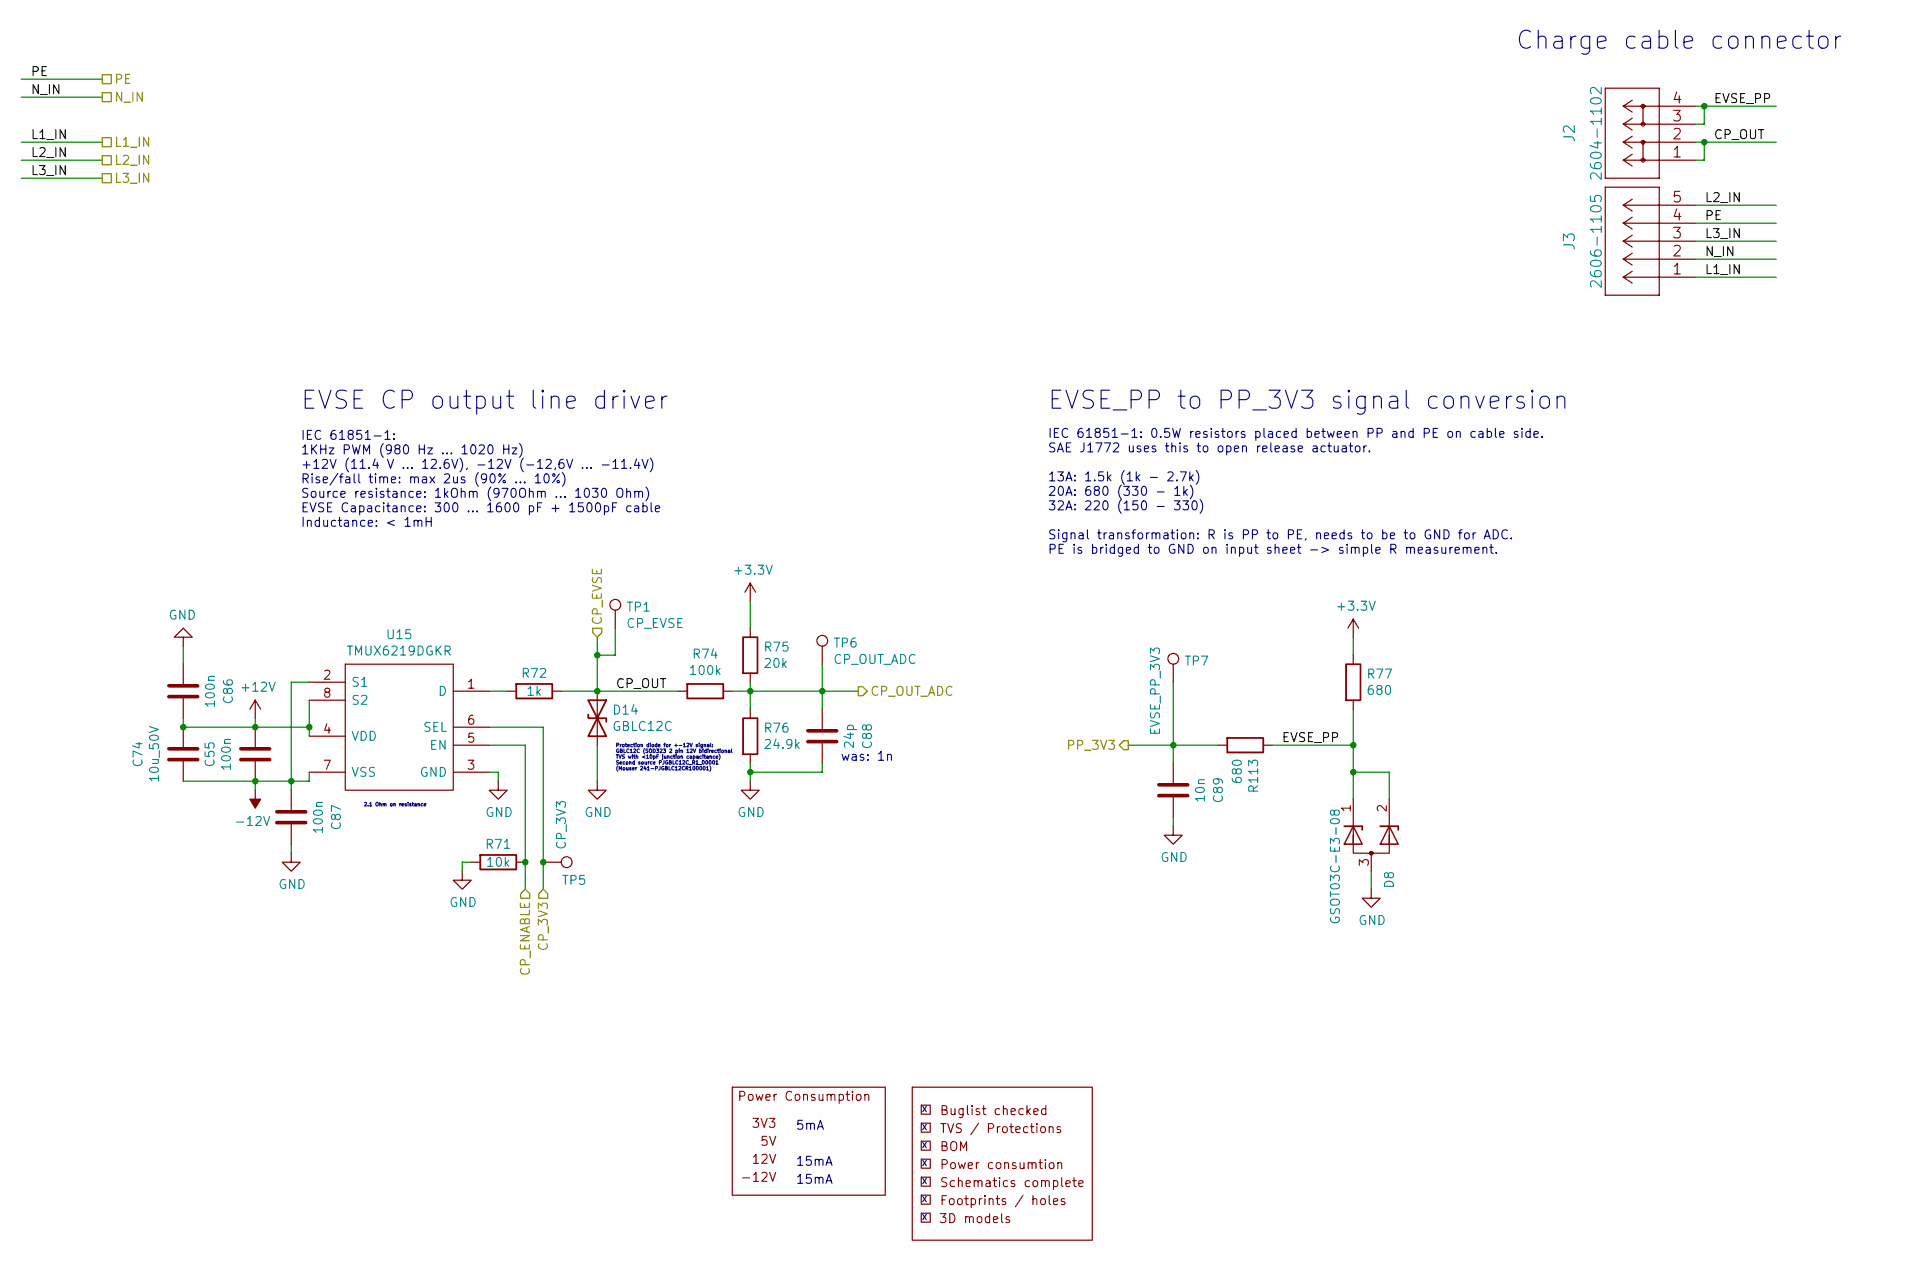
[picture p17: schematic evse.kicad_sch]

Parts:
C55, C86, C87: 100n; C_0603_1608Metric
C74: 10u_50V; C_0805_2012Metric
C88: 24p; C_0603_1608Metric
C89: 10n; C_0603_1608Metric
D8: GSOT03C-E3-08; SOT-23; Digikey GSOT03C-E3-08CT-ND
D14: GBLC12C; D_SOD-323_HandSoldering; Mouser 241-PJGBLC12CR100001
J2: 2604-1102; MPN 2604-1102
J3: 2606-1105; 2606-1105_010-000; MPN 2606-1105
R71: 10k; R_0603_1608Metric
R72: 1k; R_0603_1608Metric
R74: 100k; R_0603_1608Metric
R75: 20k; R_0603_1608Metric
R76: 24.9k; R_0603_1608Metric
R77, R113: 680; R_0603_1608Metric
TP1: CP_EVSE; TestPoint_Pad_D1.0mm
TP5: CP_3V3; TestPoint_Pad_D1.0mm
TP6: CP_OUT_ADC; TestPoint_Pad_D1.0mm
TP7: EVSE_PP_3V3; TestPoint_Pad_D1.0mm
U15: TMUX6219DGKR; SOP65P490X110-8N; Digikey 296-TMUX6219DGKRCT-ND

Connections:
+3.3V: R75.1, R77.1
+12V: C55.1, C74.1, C86.2, U15.4 (VDD), U15.8 (S2)
-12V: C55.2, C74.2, C87.1, U15.2 (S1), U15.7 (VSS)
CP_3V3: TP5.1, U15.6 (SEL)
CP_ENABLE: R71.1, U15.5 (EN)
CP_EVSE: D14.1 (A1), J2.1, J2.2, R72.1, R74.2, TP1.1
CP_OUT_ADC: C88.1, R74.1, R75.2, R76.1, TP6.1
EVSE_PP: D8.1 (K), D8.2 (K), J2.3, J2.4, R77.2, R113.1
GND: C86.1, C87.2, C88.2, C89.2, D8.3 (A), D14.2 (A2), R71.2, R76.2, U15.3 (GND)
L1_IN: J3.1
L2_IN: J3.5
L3_IN: J3.3
N_IN: J3.2
unnamed: R72.2, U15.1 (D)
PE: J3.4
PP_3V3: C89.1, R113.2, TP7.1

Notes on the sheet:
was: 1n
5mA
IEC 61851-1: 0.5W resistors placed between PP and PE on cable side. SAE J1772 uses this to open release actuator. 13A: 1.5k (1k - 2.7k) 20A: 680 (330 - 1k) 32A: 220 (150 - 330) Signal transformation: R is PP to PE, needs to be to GND for ADC. PE is bridged to GND on input sheet -> simple R measurem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
EVSE_PP to PP_3V3 signal conversion
15mA
EVSE CP output line driver
Protection diode for +-12V signal: GBLC12C (SOD323 2 pin 12V bidirectional TVS with <10pF junction capacitance) Second source PJGBLC12C_R1_00001 (Mouser 241-PJGBLC12CR100001)
Charge cable connector
2.1 Ohm on resistance
IEC 61851-1: 1KHz PWM (980 Hz ... 1020 Hz) +12V (11.4 V ... 12.6V), -12V (-12,6V ... -11.4V) Rise/fall time: max 2us (90% ... 10%) Source resistance: 1kOhm (970Ohm ... 1030 Ohm) EVSE Capacitance: 300 ... 1600 pF + 1500pF cable Inductance: < 1mH
