PionixPublic/reference-hardware/Yeti/hilevel_connector.kicad_sch

## KiCad design Yeti/hilevel_connector.kicad_sch (2022-12-22)

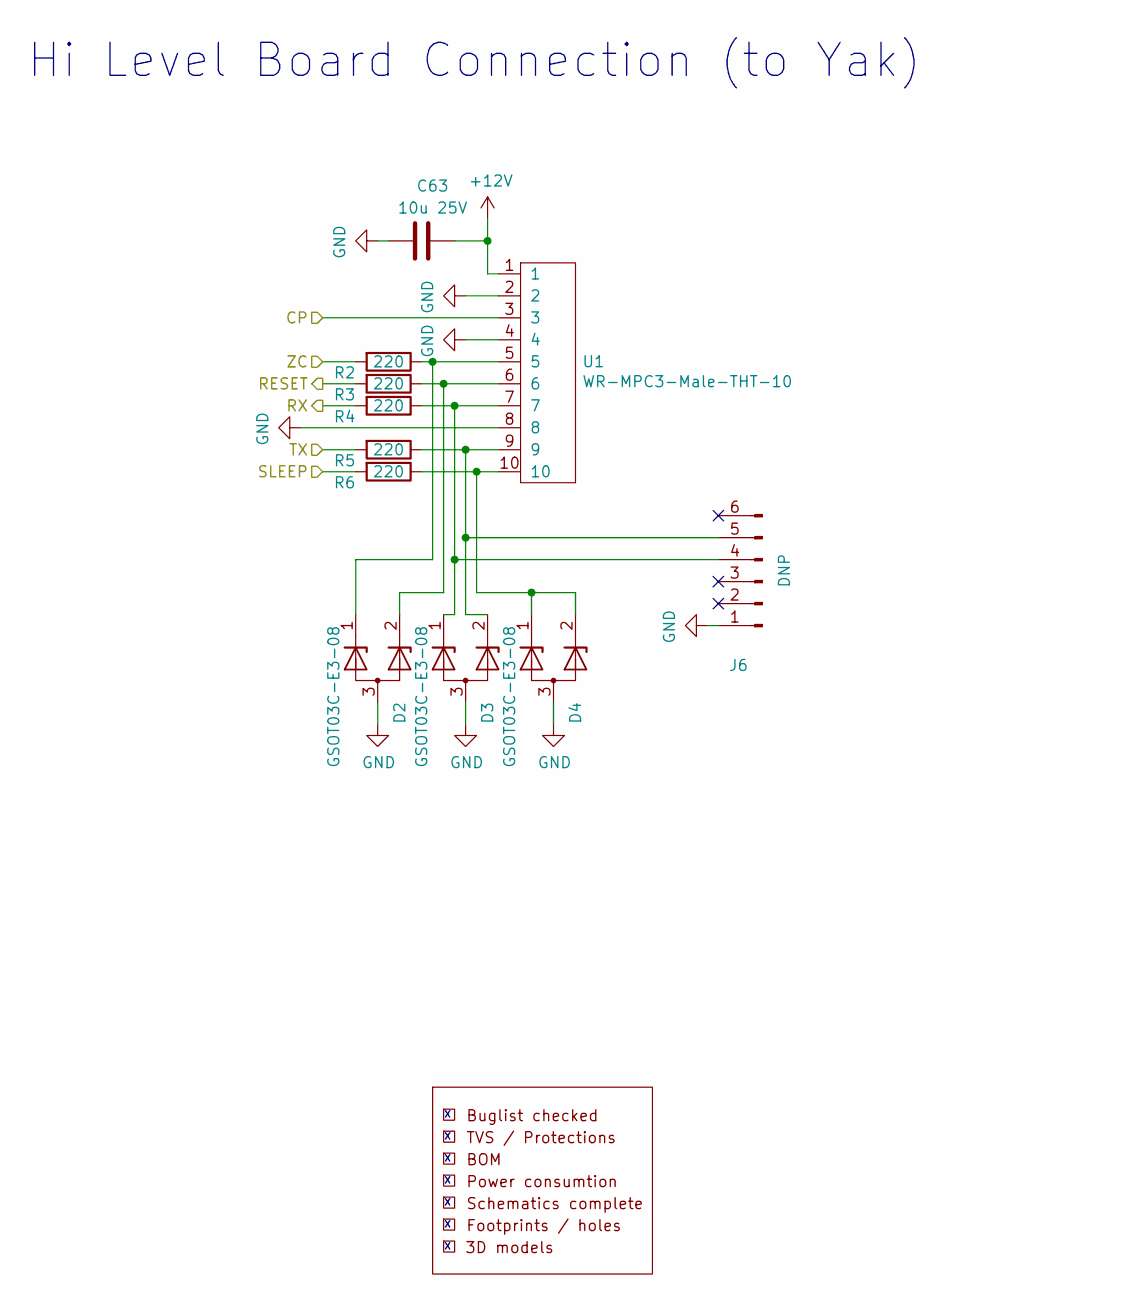
[picture p18: schematic hilevel_connector.kicad_sch]

Parts:
C63: 10u 25V; C_0603_1608Metric
D2, D3, D4: GSOT03C-E3-08; SOT-23; Digikey GSOT03C-E3-08CT-ND
J6: DNP; PinHeader_1x06_P2.54mm_Vertical
R2, R3, R4, R5, R6: 220; R_0603_1608Metric
U1: WR-MPC3-Male-THT-10; 66201021022_66201021122; MPN 66201021022_66201021122

Connections:
+12V: C63.1, U1.1
CP: U1.3
GND: C63.2, D2.3 (A), D3.3 (A), D4.3 (A), J6.1, U1.2, U1.4, U1.8
unnamed: D2.1 (K), R2.1, U1.5
unnamed: D2.2 (K), R3.1, U1.6
unnamed: D3.1 (K), J6.4, R4.1, U1.7
unnamed: D3.2 (K), J6.5, R5.1, U1.9
unnamed: D4.1 (K), D4.2 (K), R6.1, U1.10
RESET: R3.2
RX: R4.2
SLEEP: R6.2
TX: R5.2
ZC: R2.2

Notes on the sheet:
Hi Level Board Connection (to Yak)
