PionixPublic/reference-hardware/Yeti/motorlock.kicad_sch

## KiCad design Yeti/motorlock.kicad_sch (2022-12-22)

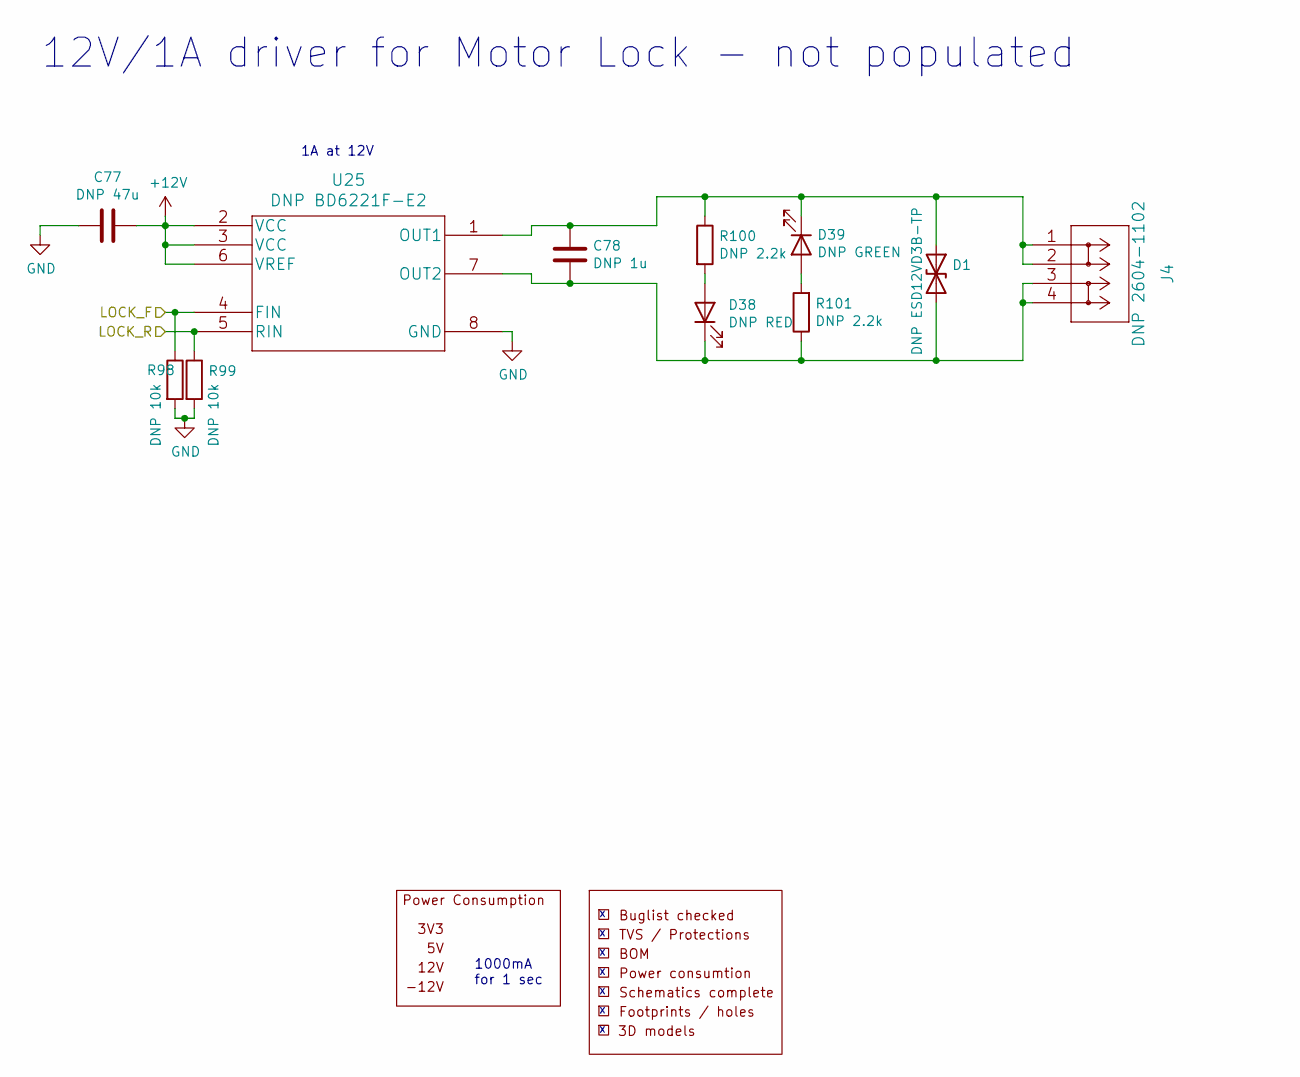
[picture p19: schematic motorlock.kicad_sch]

Parts:
C77: DNP 47u; C_1206_3216Metric
C78: DNP 1u; C_0805_2012Metric
D1: DNP ESD12VD3B-TP; D_SOD-323
D38: DNP RED; LED_0603_1608Metric
D39: DNP GREEN; LED_0603_1608Metric
J4: DNP 2604-1102; 2604-1102; MPN 2604-1102
R98, R99: DNP 10k; R_0603_1608Metric
R100, R101: DNP 2.2k; R_0603_1608Metric
U25: DNP BD6221F-E2; BD6221F-E2; MPN BD6221F-E2; Digikey BD6221F-E2CT-ND

Connections:
+12V: C77.2, U25.2 (VCC), U25.3 (VCC), U25.6 (VREF)
GND: C77.1, R98.2, R99.2, U25.8 (GND)
LOCK_F: R98.1, U25.4 (FIN)
LOCK_R: R99.1, U25.5 (RIN)
unnamed: C78.1, D1.1 (A1), D39.1 (K), J4.1, J4.2, R100.1, U25.1 (OUT1)
unnamed: C78.2, D1.2 (A2), D38.1 (K), J4.3, J4.4, R101.1, U25.7 (OUT2)
unnamed: D38.2 (A), R100.2
unnamed: D39.2 (A), R101.2

Notes on the sheet:
12V/1A driver for Motor Lock - not populated
1A at 12V
1000mA for 1 sec
