PionixPublic/reference-hardware/Yeti/powermeter-afe-neutral.kicad_sch

## KiCad design Yeti/powermeter-afe-neutral.kicad_sch (2022-12-22)

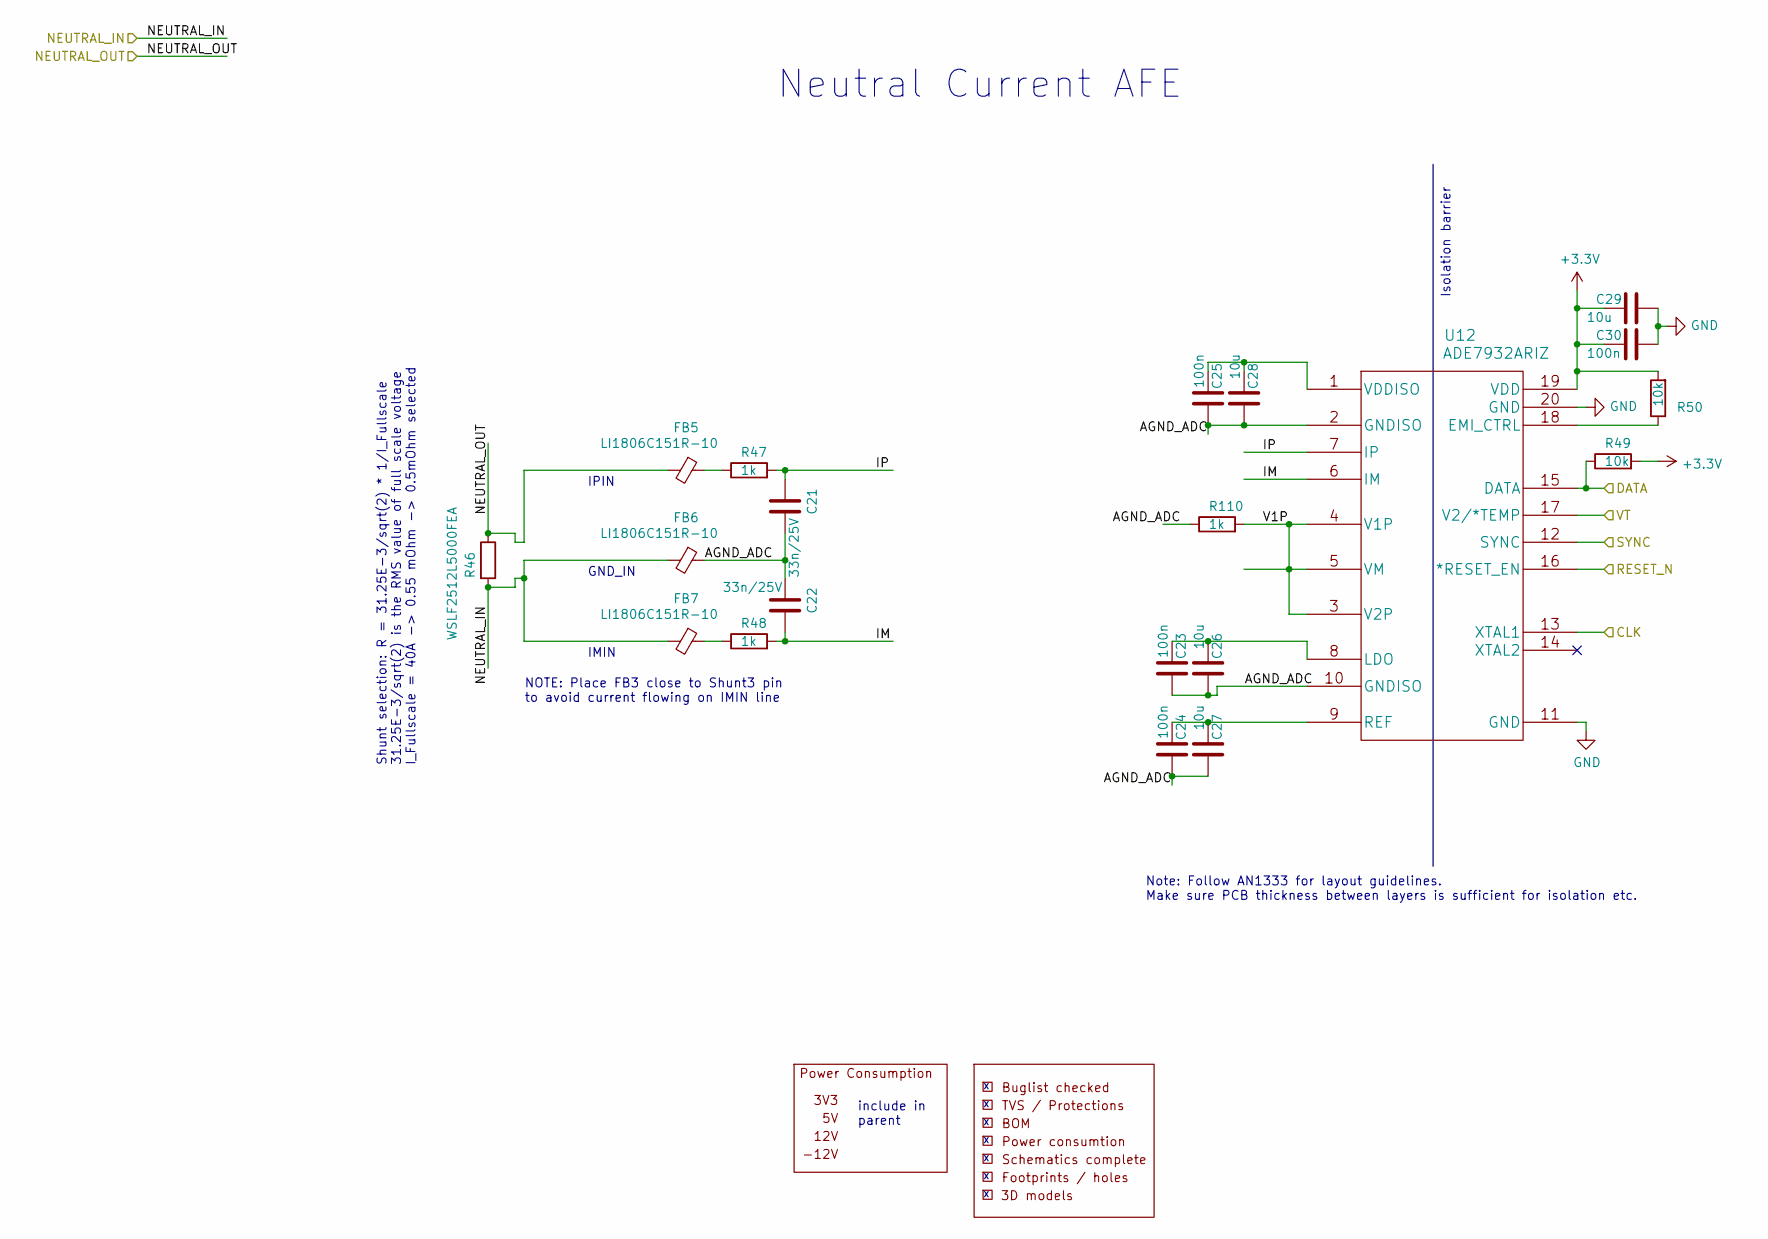
[picture p20: schematic powermeter-afe-neutral.kicad_sch]

Parts:
C21, C22: 33n/25V; C_0603_1608Metric
C23, C24, C25, C30: 100n; C_0603_1608Metric
C26, C27, C28, C29: 10u; C_0603_1608Metric
FB5, FB6, FB7: LI1806C151R-10; L_1806_4516Metric
R46: WSLF2512L5000FEA
R47, R48, R110: 1k; R_0603_1608Metric
R49, R50: 10k; R_0603_1608Metric
U12: ADE7932ARIZ; ADE7933ARIZ; MPN ADE7932ARIZ-RL; Digikey ADE7932ARIZ-RLCT-ND

Connections:
+3.3V: C29.2, C30.2, R49.2, R50.2, U12.19 (VDD)
AGND_ADC: C21.2, C22.1, C23.1, C24.1, C25.1, C26.1, C27.1, C28.1, FB6.1, R110.1, U12.2 (GNDISO), U12.10 (GNDISO)
CLK: U12.13 (XTAL1)
DATA: R49.1, U12.15 (DATA)
GND: C29.1, C30.1, U12.11 (GND), U12.20 (GND)
IM: C22.2, R48.2, U12.6 (IM)
IP: C21.1, R47.2, U12.7 (IP)
NEUTRAL_IN: FB6.2, FB7.2, R46.2
NEUTRAL_OUT: FB5.2, R46.1
unnamed: C23.2, C26.2, U12.8 (LDO)
unnamed: C24.2, C27.2, U12.9 (REF)
unnamed: C25.2, C28.2, U12.1 (VDDISO)
unnamed: FB5.1, R47.1
unnamed: FB7.1, R48.1
unnamed: R50.1, U12.18 (EMI_CTRL)
RESET_N: U12.16 (*RESET_EN)
SYNC: U12.12 (SYNC)
V1P: R110.2, U12.3 (V2P), U12.4 (V1P), U12.5 (VM)
VT: U12.17 (V2/*TEMP)

Notes on the sheet:
Shunt selection: R = 31.25E-3/sqrt(2) * 1/I_Fullscale 31.25E-3/sqrt(2) is the RMS value of full scale voltage I_Fullscale = 40A -> 0.55 mOhm -> 0.5mOhm selected
Note: Follow AN1333 for layout guidelines. Make sure PCB thickness between layers is sufficient for isolation etc.
IPIN
Isolation barrier
include in parent
NOTE: Place FB3 close to Shunt3 pin to avoid current flowing on IMIN line
Neutral Current AFE
IMIN
GND_IN
