PionixPublic/reference-hardware/Yeti/powermeter-afe.kicad_sch

## KiCad design Yeti/powermeter-afe.kicad_sch (2022-12-22)

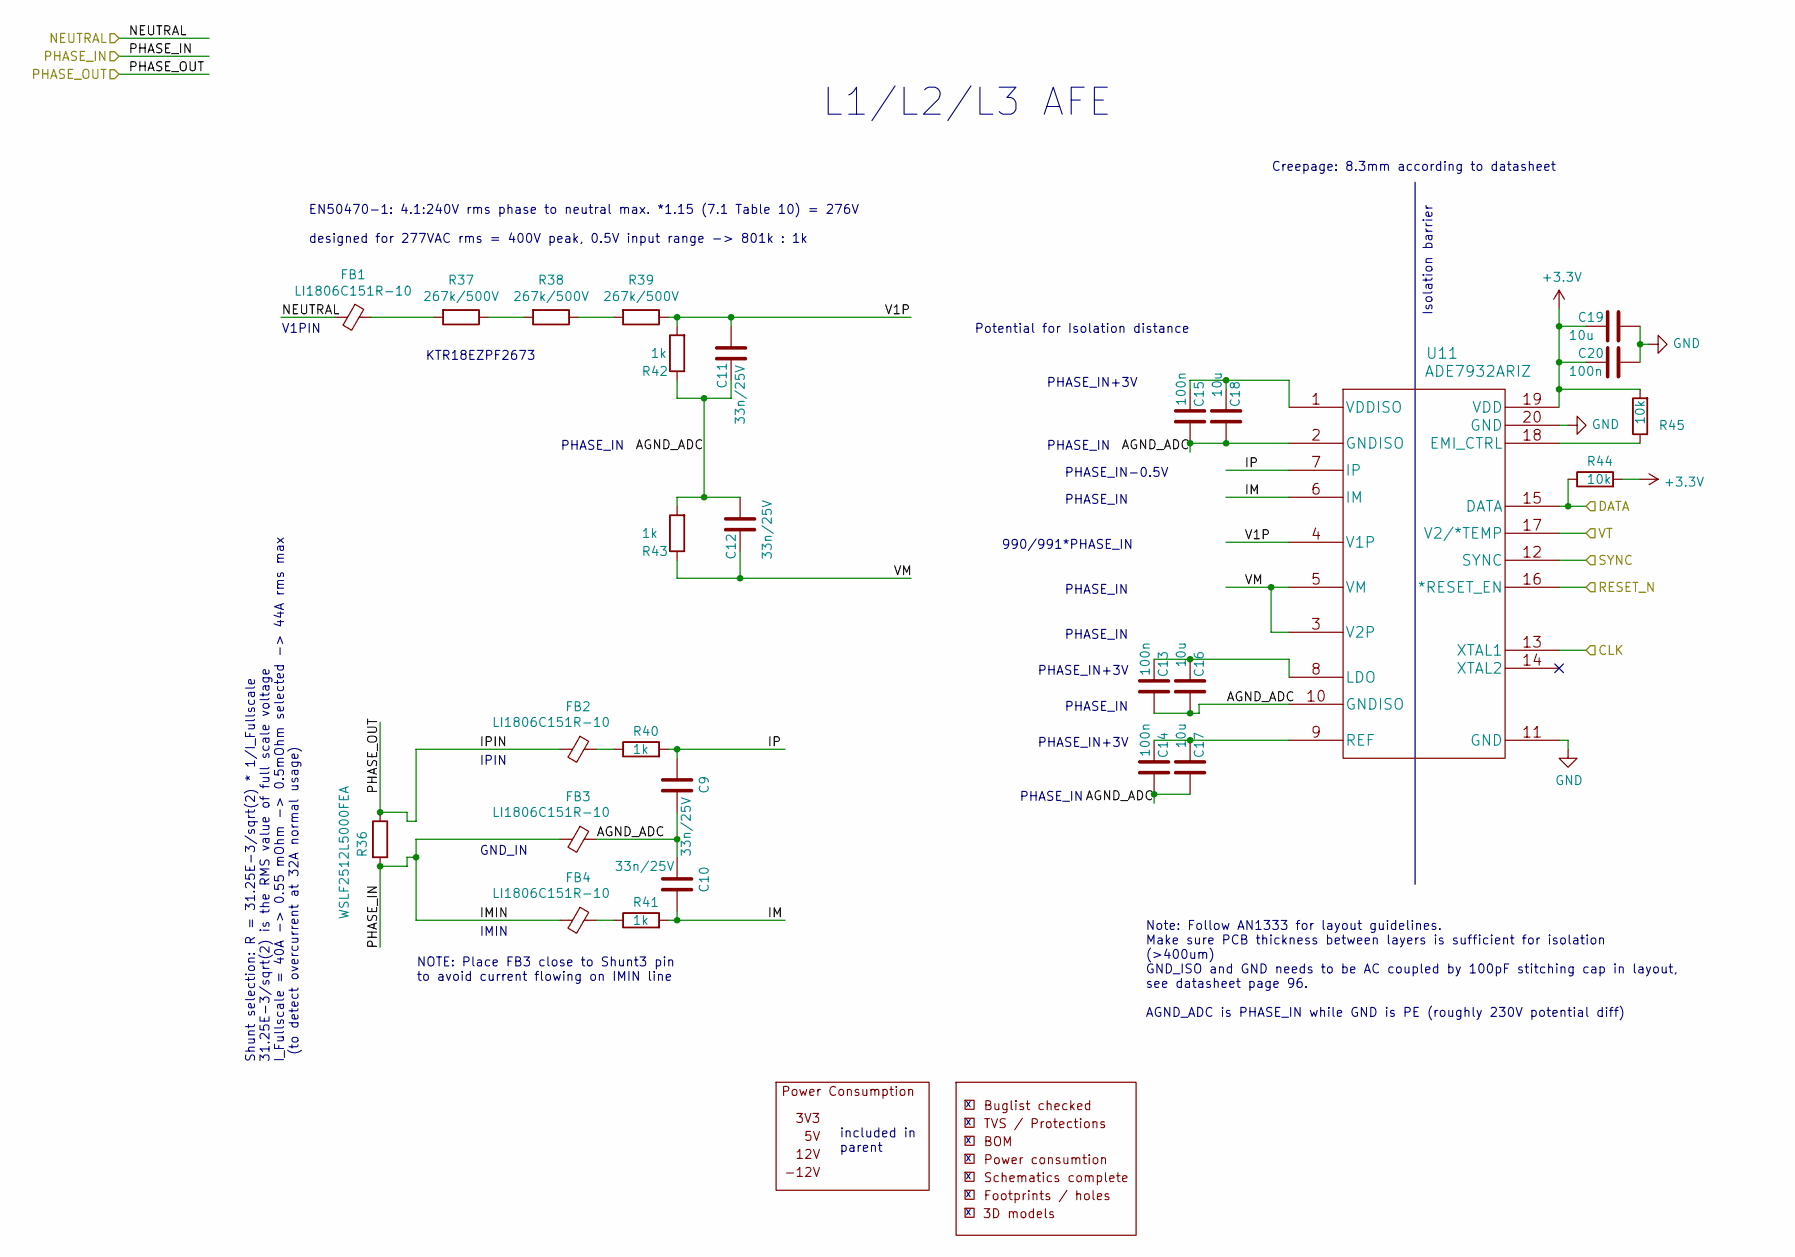
[picture p21: schematic powermeter-afe.kicad_sch]

Parts:
C9, C10, C11, C12: 33n/25V; C_0603_1608Metric
C13, C14, C15, C20: 100n; C_0603_1608Metric
C16, C17, C18, C19: 10u; C_0603_1608Metric
FB1, FB2, FB3, FB4: LI1806C151R-10; L_1806_4516Metric
R36: WSLF2512L5000FEA
R37, R38, R39: 267k/500V; R_1206_3216Metric; MPN KTR18EZPF2673; Digikey RHM267KAICT-ND
R40, R41, R42, R43: 1k; R_0603_1608Metric
R44, R45: 10k; R_0603_1608Metric
U11: ADE7932ARIZ; ADE7933ARIZ; MPN ADE7932ARIZ-RL; Digikey ADE7932ARIZ-RLCT-ND

Connections:
+3.3V: C19.2, C20.2, R44.2, R45.2, U11.19 (VDD)
AGND_ADC: C9.2, C10.1, C11.2, C12.1, C13.1, C14.1, C15.1, C16.1, C17.1, C18.1, FB3.1, R42.1, R43.2, U11.2 (GNDISO), U11.10 (GNDISO)
CLK: U11.13 (XTAL1)
DATA: R44.1, U11.15 (DATA)
GND: C19.1, C20.1, U11.11 (GND), U11.20 (GND)
IM: C10.2, R41.2, U11.6 (IM)
IMIN: FB3.2, FB4.2, R36.2
IP: C9.1, R40.2, U11.7 (IP)
IPIN: FB2.2, R36.1
NEUTRAL: FB1.2
unnamed: C13.2, C16.2, U11.8 (LDO)
unnamed: C14.2, C17.2, U11.9 (REF)
unnamed: C15.2, C18.2, U11.1 (VDDISO)
unnamed: FB1.1, R37.2
unnamed: FB2.1, R40.1
unnamed: FB4.1, R41.1
unnamed: R37.1, R38.2
unnamed: R38.1, R39.2
unnamed: R45.1, U11.18 (EMI_CTRL)
RESET_N: U11.16 (*RESET_EN)
SYNC: U11.12 (SYNC)
V1P: C11.1, R39.1, R42.2, U11.4 (V1P)
VM: C12.2, R43.1, U11.3 (V2P), U11.5 (VM)
VT: U11.17 (V2/*TEMP)

Notes on the sheet:
Potential for Isolation distance
EN50470-1: 4.1:240V rms phase to neutral max. *1.15 (7.1 Table 10) = 276V designed for 277VAC rms = 400V peak, 0.5V input range -> 801k : 1k
PHASE_IN
PHASE_IN+3V
Creepage: 8.3mm according to datasheet
PHASE_IN-0.5V
GND_IN
included in parent
Note: Follow AN1333 for layout guidelines. Make sure PCB thickness between layers is sufficient for isolation (>400um) GND_ISO and GND needs to be AC coupled by 100pF stitching cap in layout, see datasheet page 96. AGND_ADC is PHASE_IN while GND is PE (roughly 230V potential diff)
990/991*PHASE_IN
NOTE: Place FB3 close to Shunt3 pin to avoid current flowing on IMIN line
V1PIN
Isolation barrier
IMIN
KTR18EZPF2673
L1/L2/L3 AFE
Shunt selection: R = 31.25E-3/sqrt(2) * 1/I_Fullscale 31.25E-3/sqrt(2) is the RMS value of full scale voltage I_Fullscale = 40A -> 0.55 mOhm -> 0.5mOhm selected -> 44A rms max (to detect overcurrent at 32A normal usage)
IPIN
