PionixPublic/reference-hardware/Yeti/powermeter.kicad_sch

## KiCad design Yeti/powermeter.kicad_sch (2022-12-22)

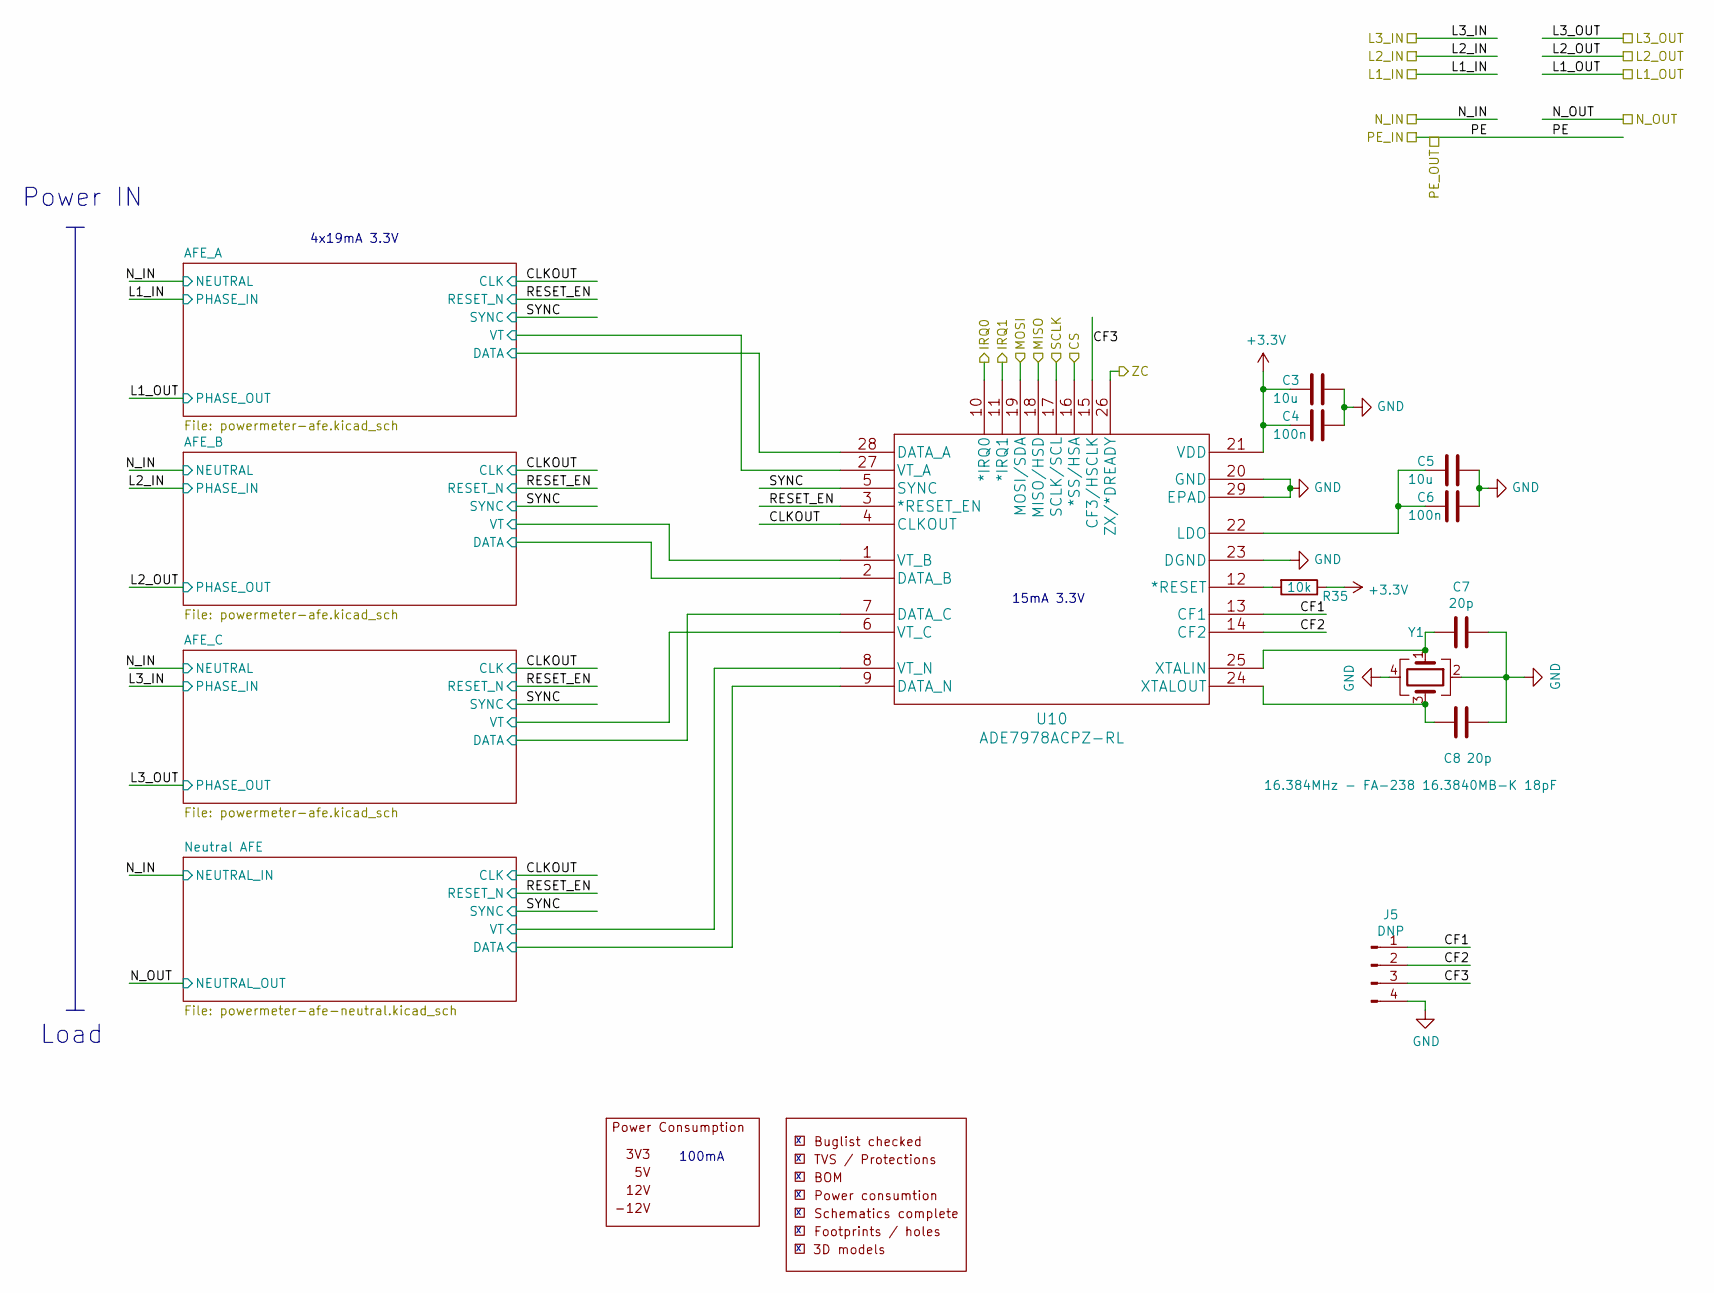
[picture p22: schematic powermeter.kicad_sch]

Parts:
C3, C5: 10u; C_0603_1608Metric
C4, C6: 100n; C_0603_1608Metric
C7, C8: 20p; C_0603_1608Metric
J5: DNP; PinHeader_1x04_P2.54mm_Vertical
R35: 10k; R_0603_1608Metric
U10: ADE7978ACPZ-RL; MPN ADE7978ACPZ-RL; Digikey 505-ADE7978ACPZ-RLCT-ND
Y1: 16.384MHz - FA-238 16.3840MB-K 18pF; Crystal_SMD_SeikoEpson_FA238-4Pin_3.2x2.5mm; MPN FA-238 16.3840MB-K; Digikey SER4206-ND

Connections:
+3.3V: C3.2, C4.2, R35.1, U10.21 (VDD)
CF1: J5.1, U10.13 (CF1)
CF2: J5.2, U10.14 (CF2)
CF3: J5.3, U10.15 (CF3/HSCLK)
CLKOUT: U10.4 (CLKOUT)
CS: U10.16 (*SS/HSA)
DATA: U10.2 (DATA_B), U10.7 (DATA_C), U10.9 (DATA_N), U10.28 (DATA_A)
GND: C3.1, C4.1, C5.1, C6.1, C7.1, C8.1, J5.4, U10.20 (GND), U10.23 (DGND), U10.29 (EPAD), Y1.2, Y1.4
IRQ0: U10.10 (*IRQ0)
IRQ1: U10.11 (*IRQ1)
MISO: U10.18 (MISO/HSD)
MOSI: U10.19 (MOSI/SDA)
unnamed: C5.2, C6.2, U10.22 (LDO)
unnamed: C7.2, U10.25 (XTALIN), Y1.1
unnamed: C8.2, U10.24 (XTALOUT), Y1.3
unnamed: R35.2, U10.12 (*RESET)
RESET_EN: U10.3 (*RESET_EN)
SCLK: U10.17 (SCLK/SCL)
SYNC: U10.5 (SYNC)
VT: U10.1 (VT_B), U10.6 (VT_C), U10.8 (VT_N), U10.27 (VT_A)
ZC: U10.26 (ZX/*DREADY)

Notes on the sheet:
15mA 3.3V
4x19mA 3.3V
Power IN
100mA
Load
