PionixPublic/reference-hardware/Yeti/powersupply.kicad_sch

## KiCad design Yeti/powersupply.kicad_sch (2022-12-22)

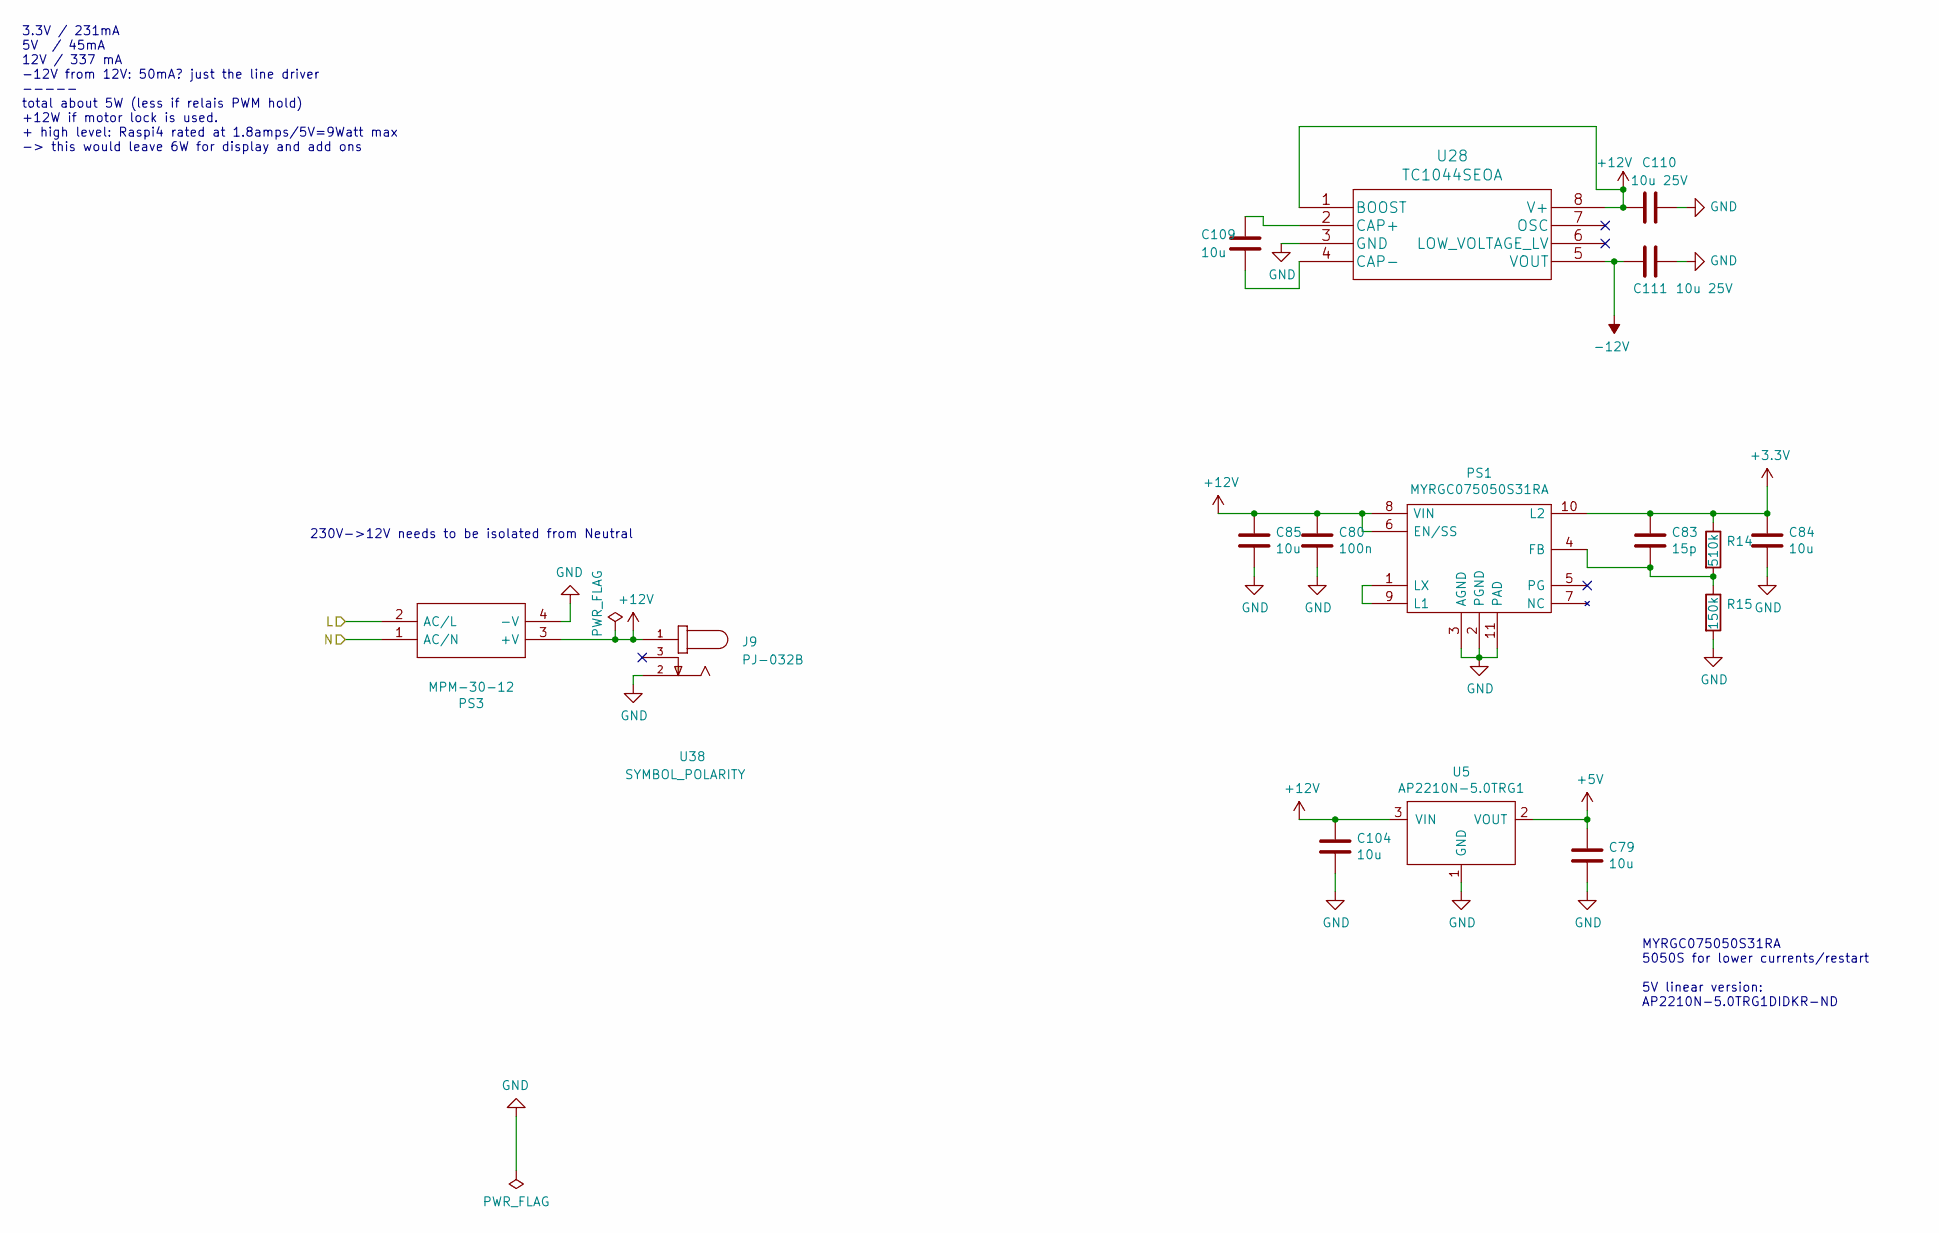
[picture p23: schematic powersupply.kicad_sch]

Parts:
C79, C84, C85, C104, C109: 10u; C_0603_1608Metric
C80: 100n; C_0603_1608Metric
C83: 15p; C_0603_1608Metric
C110, C111: 10u 25V; C_0603_1608Metric
J9: PJ-032B; CUI_PJ-032B; DIGI-KEY_PART_NUMBER CP-032A-ND
PS1: MYRGC075050S31RA; MPN MYRGC075050S31RA; Mouser 81-MYRGC075050S31RA
PS3: MPM-30-12; MPM3012_dualsocket; Mouser Part Number 709-MPM-30-12
R14: 510k; R_0603_1608Metric
R15: 150k; R_0603_1608Metric
U5: AP2210N-5.0TRG1; SOT95P280X145-3N; MPN AP2210N-5.0TRG1; Digikey AP2210N-5.0TRG1DIDKR-ND
U28: TC1044SEOA; MPN TC1044SEOA713; Digikey TC1044SEOA713CT-ND
U38: SYMBOL_POLARITY; Polarity_Center_Positive_6mm_SilkScreen

Connections:
+3.3V: C83.1, C84.1, PS1.10 (L2), R14.1
+5V: C79.1, U5.2 (VOUT)
+12V: C80.1, C85.1, C104.1, C110.2, J9.1, PS1.6 (EN/SS), PS1.8 (VIN), PS3.3 (+V), U5.3 (VIN), U28.1 (BOOST), U28.8 (V+)
-12V: C111.2, U28.5 (VOUT)
GND: C79.2, C80.2, C84.2, C85.2, C104.2, C110.1, C111.1, J9.2, PS1.2 (PGND), PS1.3 (AGND), PS1.11 (PAD), PS3.4 (-V), R15.2, U5.1 (GND), U28.3 (GND)
L: PS3.2 (AC/L)
N: PS3.1 (AC/N)
unnamed: C83.2, PS1.4 (FB), R14.2, R15.1
unnamed: C109.1, U28.2 (CAP+)
unnamed: C109.2, U28.4 (CAP-)
unnamed: PS1.1 (LX), PS1.9 (L1)

Notes on the sheet:
MYRGC075050S31RA 5050S for lower currents/restart 5V linear version: AP2210N-5.0TRG1DIDKR-ND
3.3V / 231mA 5V / 45mA 12V / 337 mA -12V from 12V: 50mA? just the line driver ----- total about 5W (less if relais PWM hold) +12W if motor lock is used. + high level: Raspi4 rated at 1.8amps/5V=9Watt max -> this would leave 6W for display and add ons
230V->12V needs to be isolated from Neutral
