PionixPublic/reference-hardware/Yeti/rcd.kicad_sch

## KiCad design Yeti/rcd.kicad_sch (2022-12-22)

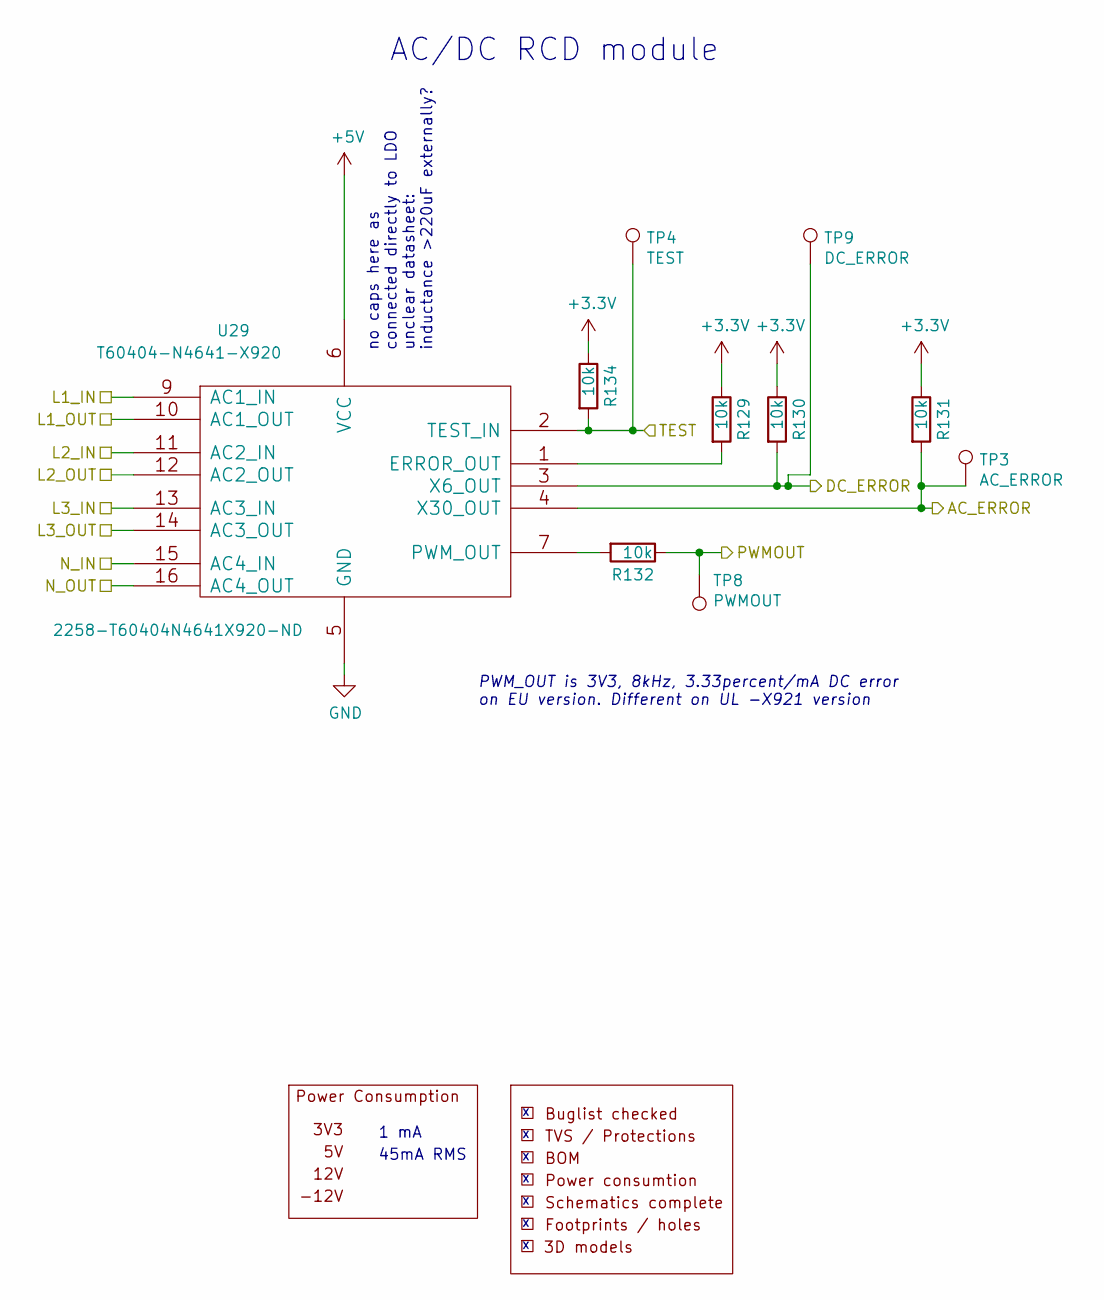
[picture p24: schematic rcd.kicad_sch]

Parts:
R129, R130, R131, R132, R134: 10k; R_0603_1608Metric
TP3: AC_ERROR; TestPoint_Pad_D1.0mm
TP4: TEST; TestPoint_Pad_D1.0mm
TP8: PWMOUT; TestPoint_Pad_D1.0mm
TP9: DC_ERROR; TestPoint_Pad_D1.0mm
U29: T60404-N4641-X920; MPN T60404N4641X920; Digikey 2258-T60404N4641X920-ND

Connections:
+3.3V: R129.1, R130.1, R131.1, R134.1
+5V: U29.6 (VCC)
AC_ERROR: R131.2, TP3.1, U29.4 (X30_OUT)
DC_ERROR: R130.2, TP9.1, U29.3 (X6_OUT)
GND: U29.5 (GND)
L1_IN: U29.9 (AC1_IN)
L1_OUT: U29.10 (AC1_OUT)
L2_IN: U29.11 (AC2_IN)
L2_OUT: U29.12 (AC2_OUT)
L3_IN: U29.13 (AC3_IN)
L3_OUT: U29.14 (AC3_OUT)
N_IN: U29.15 (AC4_IN)
N_OUT: U29.16 (AC4_OUT)
unnamed: R129.2, U29.1 (ERROR_OUT)
unnamed: R132.2, U29.7 (PWM_OUT)
PWMOUT: R132.1, TP8.1
TEST: R134.2, TP4.1, U29.2 (TEST_IN)

Notes on the sheet:
45mA RMS
AC/DC RCD module
no caps here as connected directly to LDO unclear datasheet: inductance >220uF externally?
PWM_OUT is 3V3, 8kHz, 3.33percent/mA DC error on EU version. Different on UL -X921 version
1 mA
