PionixPublic/reference-hardware/Yeti/relais.kicad_sch

## KiCad design Yeti/relais.kicad_sch (2022-12-22)

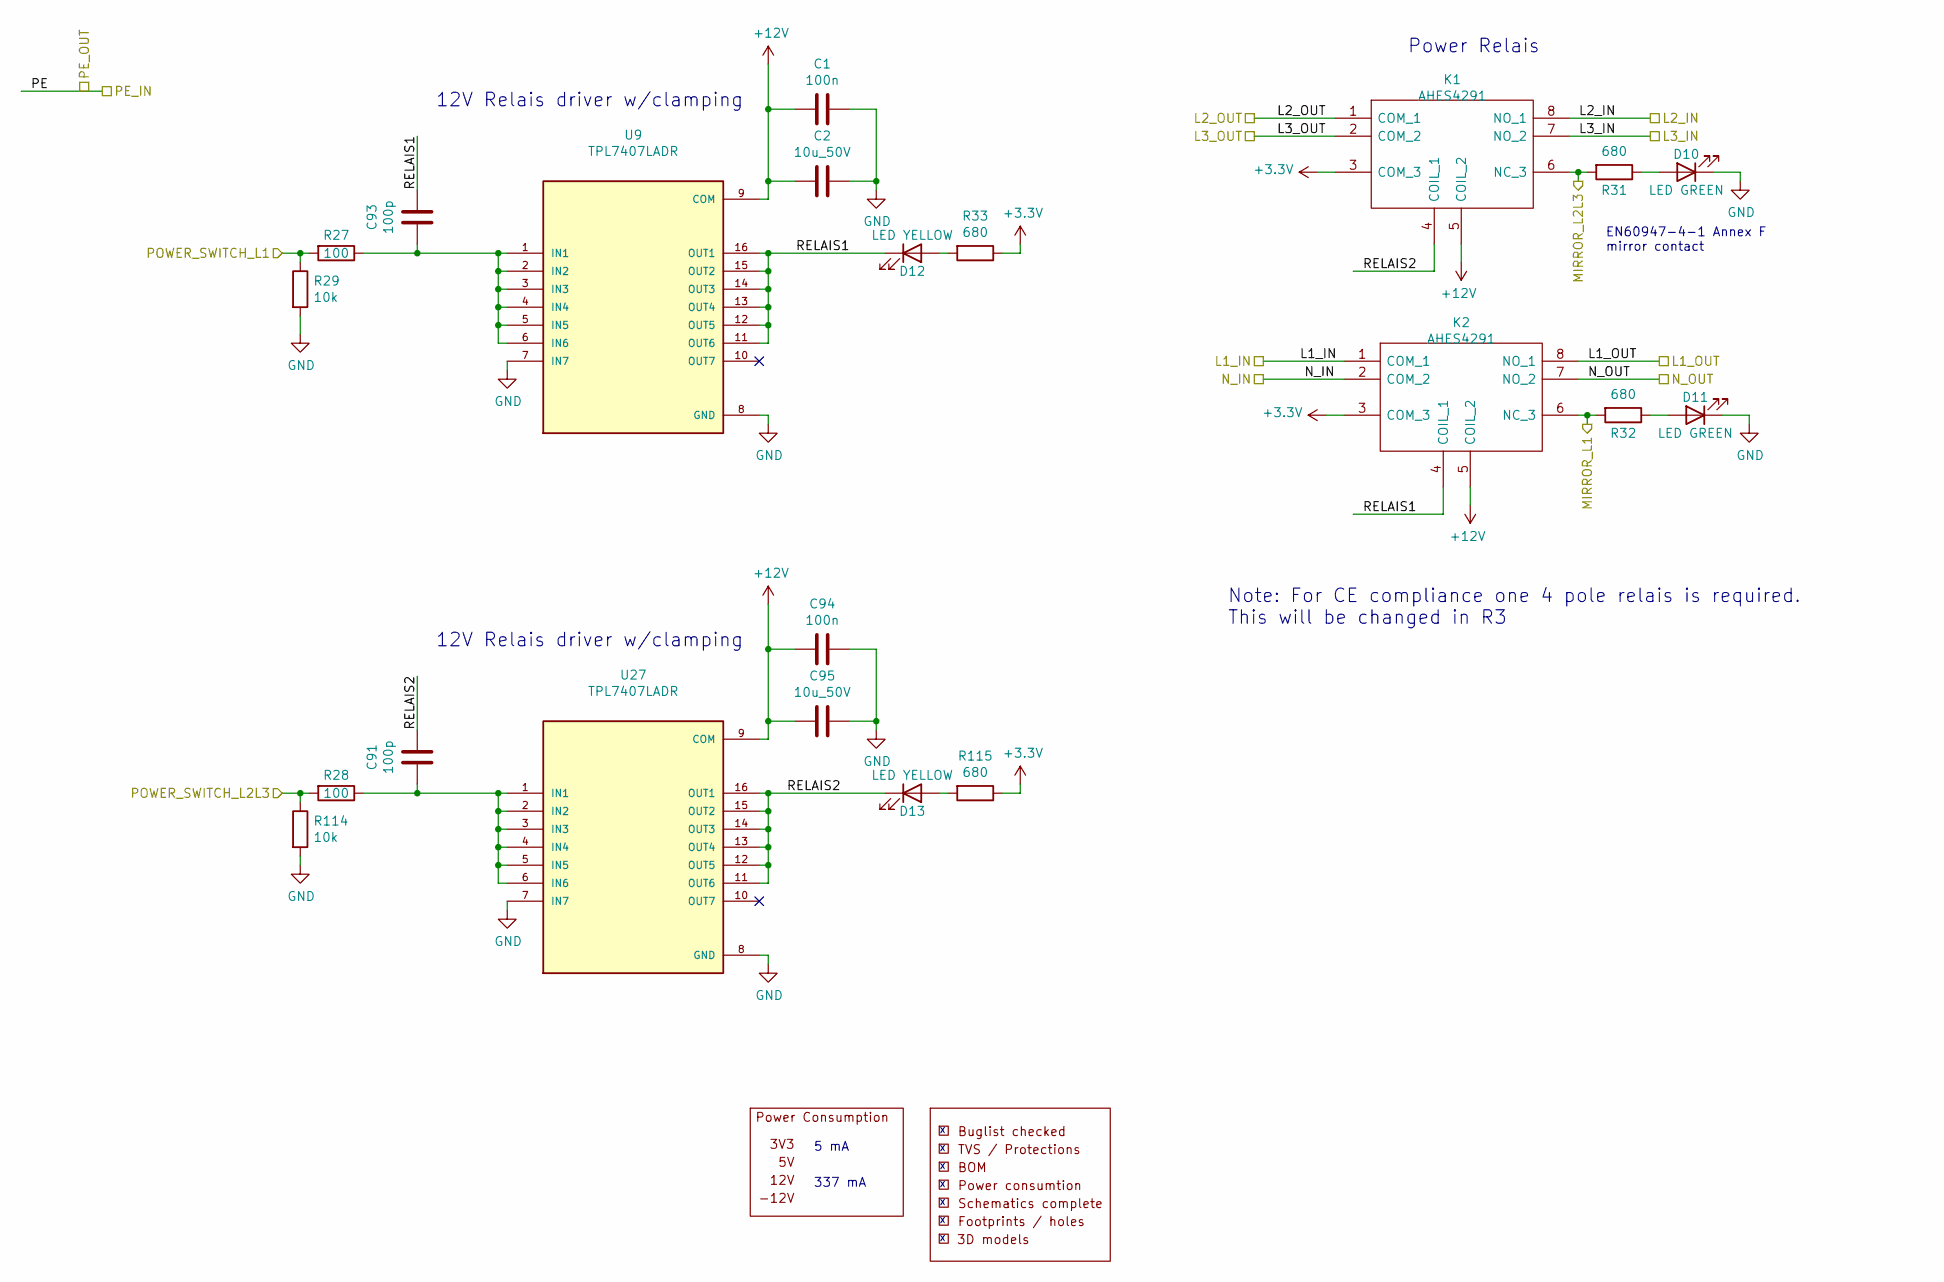
[picture p25: schematic relais.kicad_sch]

Parts:
C1, C94: 100n; C_0603_1608Metric
C2, C95: 10u_50V; C_0805_2012Metric
C91, C93: 100p; C_0603_1608Metric
D10, D11: LED GREEN; LED_0603_1608Metric
D12, D13: LED YELLOW; LED_0603_1608Metric
K1, K2: AHES4291; Manufacturer_Part_Number AHES4291; Mouser Part Number 769-AHES4291
R27, R28: 100; R_0603_1608Metric
R29, R114: 10k; R_0603_1608Metric
R31, R32, R33, R115: 680; R_0603_1608Metric
U9, U27: TPL7407LADR; SOIC-16_3.9x9.9mm_P1.27mm; MPN TPL7407LADR; Digikey 296-51862-1-ND

Connections:
+3.3V: K1.3 (COM_3), K2.3 (COM_3), R33.1, R115.1
+12V: C1.2, C2.2, C94.2, C95.2, K1.5 (COIL_2), K2.5 (COIL_2), U9.9 (COM), U27.9 (COM)
GND: C1.1, C2.1, C94.1, C95.1, D10.1 (K), D11.1 (K), R29.2, R114.2, U9.7 (IN7), U9.8 (GND), U27.7 (IN7), U27.8 (GND)
L1_IN: K2.1 (COM_1)
L1_OUT: K2.8 (NO_1)
L2_IN: K1.8 (NO_1)
L2_OUT: K1.1 (COM_1)
L3_IN: K1.7 (NO_2)
L3_OUT: K1.2 (COM_2)
MIRROR_L1: K2.6 (NC_3), R32.2
MIRROR_L2L3: K1.6 (NC_3), R31.2
N_IN: K2.2 (COM_2)
N_OUT: K2.7 (NO_2)
unnamed: C91.2, R28.1, U27.1 (IN1), U27.2 (IN2), U27.3 (IN3), U27.4 (IN4), U27.5 (IN5), U27.6 (IN6)
unnamed: C93.2, R27.1, U9.1 (IN1), U9.2 (IN2), U9.3 (IN3), U9.4 (IN4), U9.5 (IN5), U9.6 (IN6)
unnamed: D10.2 (A), R31.1
unnamed: D11.2 (A), R32.1
unnamed: D12.2 (A), R33.2
unnamed: D13.2 (A), R115.2
POWER_SWITCH_L1: R27.2, R29.1
POWER_SWITCH_L2L3: R28.2, R114.1
RELAIS1: C93.1, D12.1 (K), K2.4 (COIL_1), U9.11 (OUT6), U9.12 (OUT5), U9.13 (OUT4), U9.14 (OUT3), U9.15 (OUT2), U9.16 (OUT1)
RELAIS2: C91.1, D13.1 (K), K1.4 (COIL_1), U27.11 (OUT6), U27.12 (OUT5), U27.13 (OUT4), U27.14 (OUT3), U27.15 (OUT2), U27.16 (OUT1)

Notes on the sheet:
EN60947-4-1 Annex F mirror contact
Note: For CE compliance one 4 pole relais is required. This will be changed in R3
337 mA
5 mA
12V Relais driver w/clamping
Power Relais
