PionixPublic/reference-hardware/Yeti/yeti.kicad_sch

## KiCad design Yeti/yeti.kicad_sch (2022-12-22)

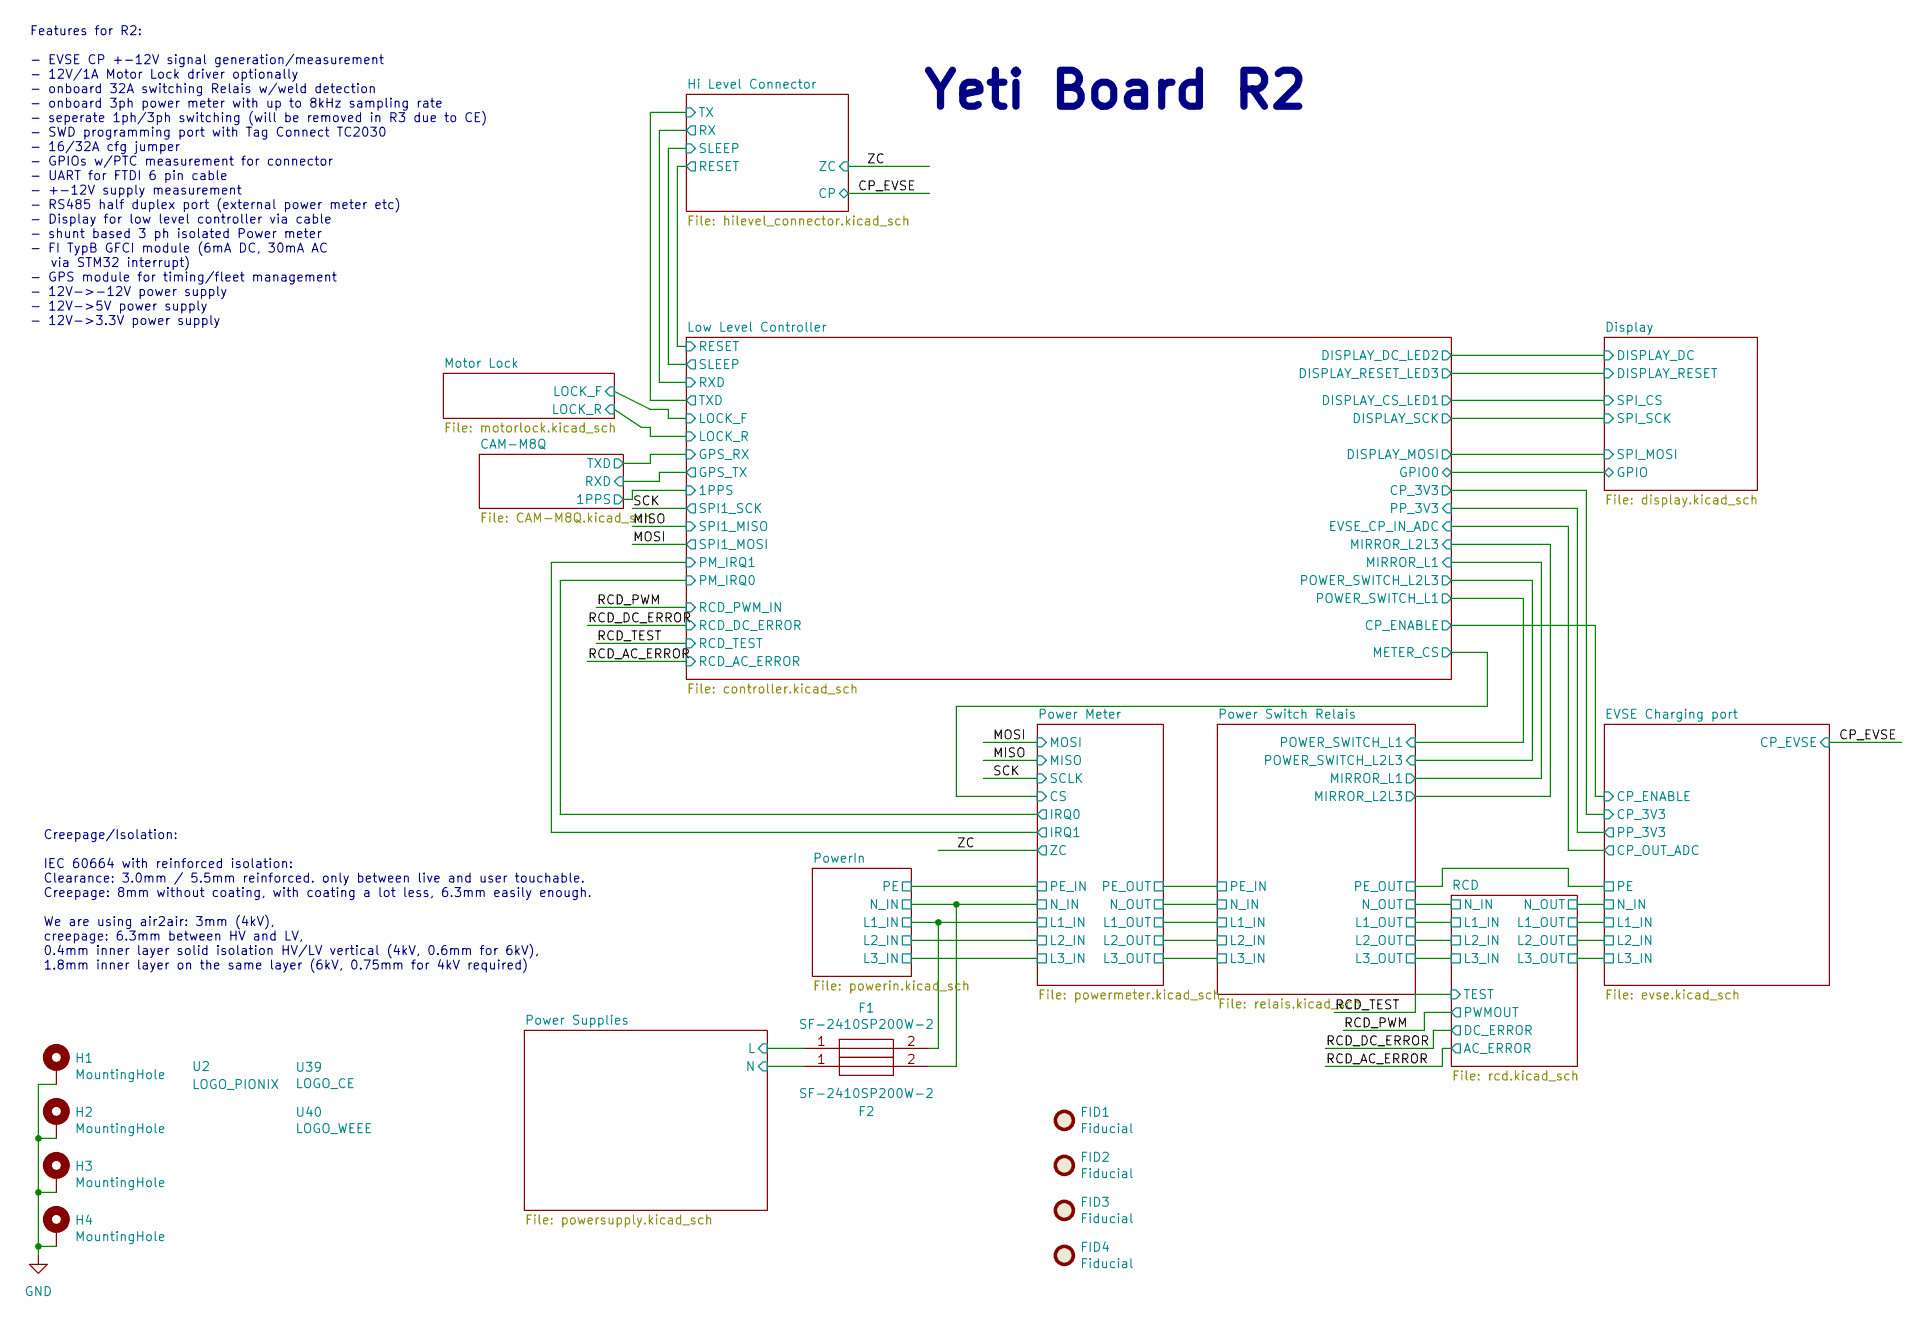
[picture p26: schematic yeti.kicad_sch]

Parts:
F1, F2: SF-2410SP200W-2; FUSC6125X236N; Mouser Part Number 652-SF-2410SP200W-2
FID1, FID2, FID3, FID4: Fiducial; Fiducial_1mm_Mask3mm
H1, H2, H3, H4: MountingHole; MountingHole_3.2mm_M3_ISO7380_Pad_TopBottom
U2: LOGO_PIONIX; pionix-logo
U39: LOGO_CE; CE-Logo_8.5x6mm_SilkScreen
U40: LOGO_WEEE; WEEE-Logo_4.2x6mm_SilkScreen

Connections:
GND: H1.1, H2.1, H3.1, H4.1
L: F1.1
L1_IN: F1.2
N: F2.1
N_IN: F2.2

Notes on the sheet:
Features for R2: - EVSE CP +-12V signal generation/measurement - 12V/1A Motor Lock driver optionally - onboard 32A switching Relais w/weld detection - onboard 3ph power meter with up to 8kHz sampling rate - seperate 1ph/3ph switching (will be removed in R3 due to CE) - SWD programming port with Tag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
Yeti Board R2
Creepage/Isolation: IEC 60664 with reinforced isolation: Clearance: 3.0mm / 5.5mm reinforced. only between live and user touchable. Creepage: 8mm without coating, with coating a lot less, 6.3mm easily enough. We are using air2air: 3mm (4kV), creepage: 6.3mm between HV and LV, 0.4mm inner layer soli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
